amauryvandenberghe/Bras-robos/05_Documentation/images/anciennes analyses/avant 06-11/sw_articulation_lacet.png

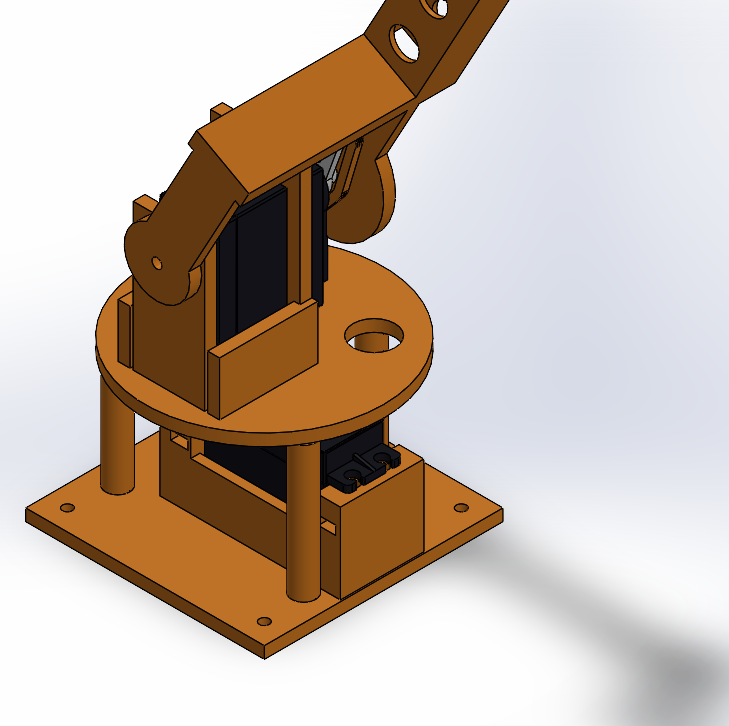
05_Documentation/images/anciennes analyses/avant 06-11/sw_articulation_lacet.png
