amauryvandenberghe/Bras-robos/01_SolidWorks/1_VERSION_FINALE (a ouvrir)/Documents/Bras 50cm (13-11).png

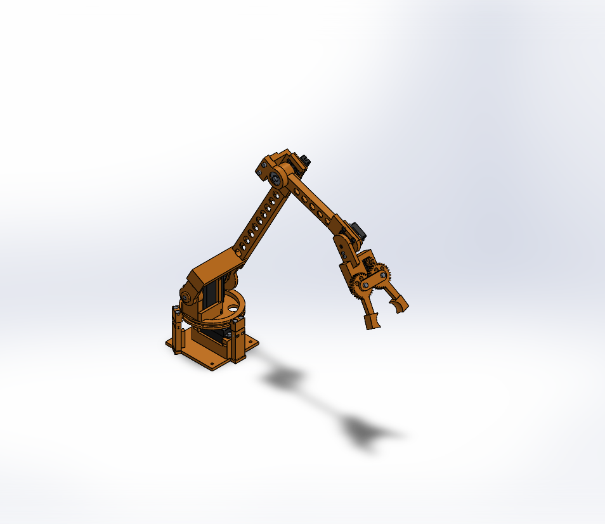
01_SolidWorks/1_VERSION_FINALE (a ouvrir)/Documents/Bras 50cm (13-11).png
