amauryvandenberghe/Bras-robos/01_SolidWorks/3_Anciennes versions/3c_29-10 sans empreintes de palonniers/Bras 50cm.png

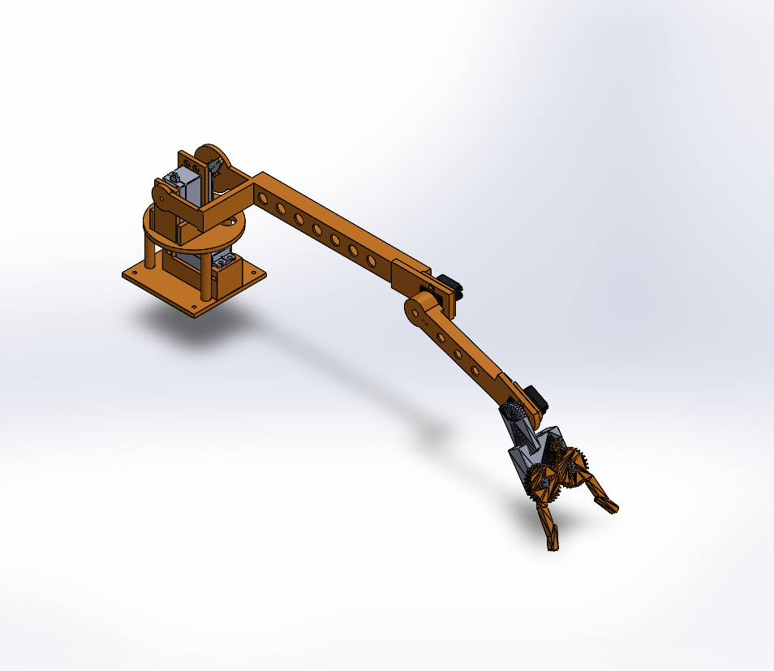
01_SolidWorks/3_Anciennes versions/3c_29-10 sans empreintes de palonniers/Bras 50cm.png
