amauryvandenberghe/Bras-robos/01_SolidWorks/3_Anciennes versions/3g_06-11 avec roulements sans visserie/Bras 50cm.png

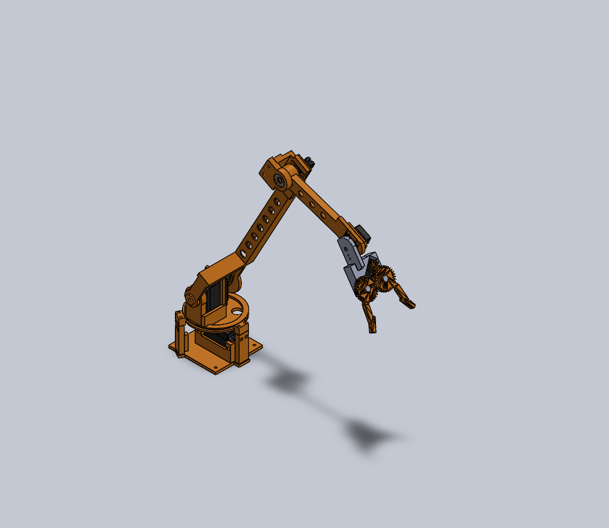
01_SolidWorks/3_Anciennes versions/3g_06-11 avec roulements sans visserie/Bras 50cm.png
