amauryvandenberghe/Bras-robos/01_SolidWorks/3_Anciennes versions/3l_13-11 avant renforts U, patins, pince/Documents/Implantation capteurs 13 mm.png

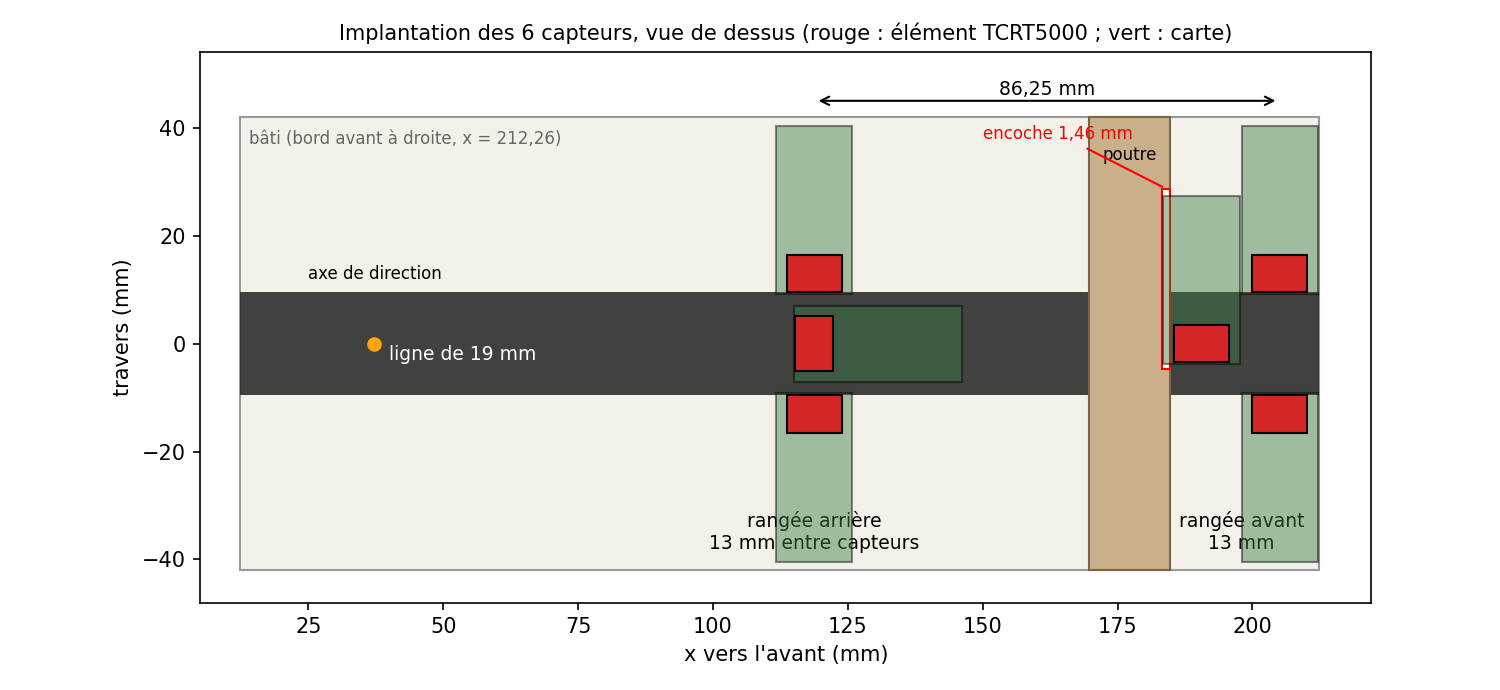
01_SolidWorks/3_Anciennes versions/3l_13-11 avant renforts U, patins, pince/Documents/Implantation capteurs 13 mm.png
