amauryvandenberghe/Bras-robos/01_SolidWorks/3_Anciennes versions/3l_13-11 avant renforts U, patins, pince/Documents/Vues 07-11/capteurs 2 rangees (iso).png

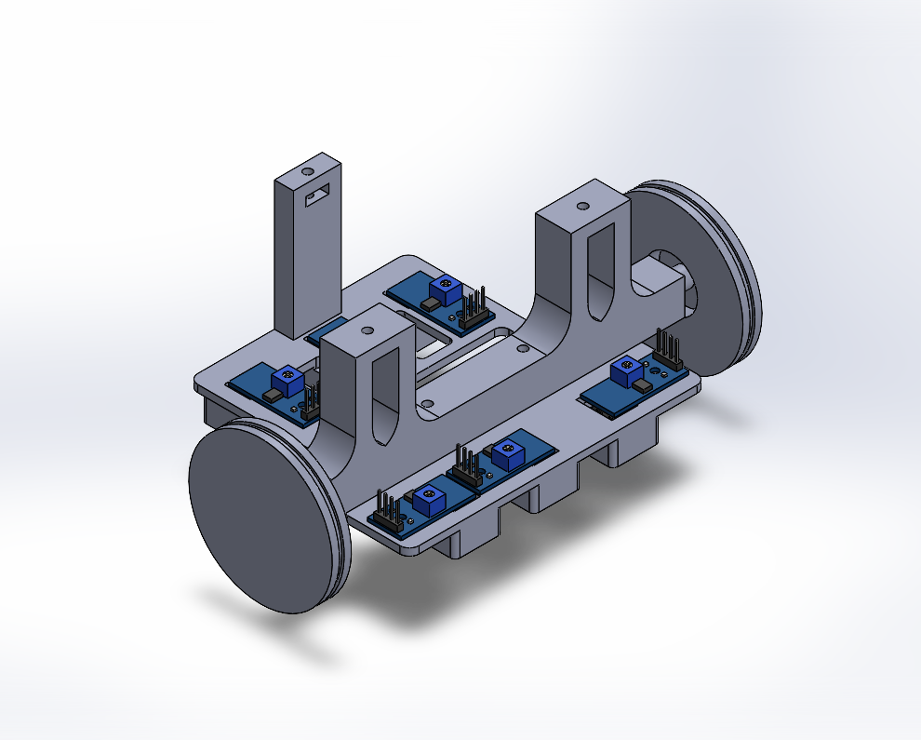
01_SolidWorks/3_Anciennes versions/3l_13-11 avant renforts U, patins, pince/Documents/Vues 07-11/capteurs 2 rangees (iso).png
