amauryvandenberghe/Bras-robos/04_Simulation_Gazebo/parcours/plateau.png

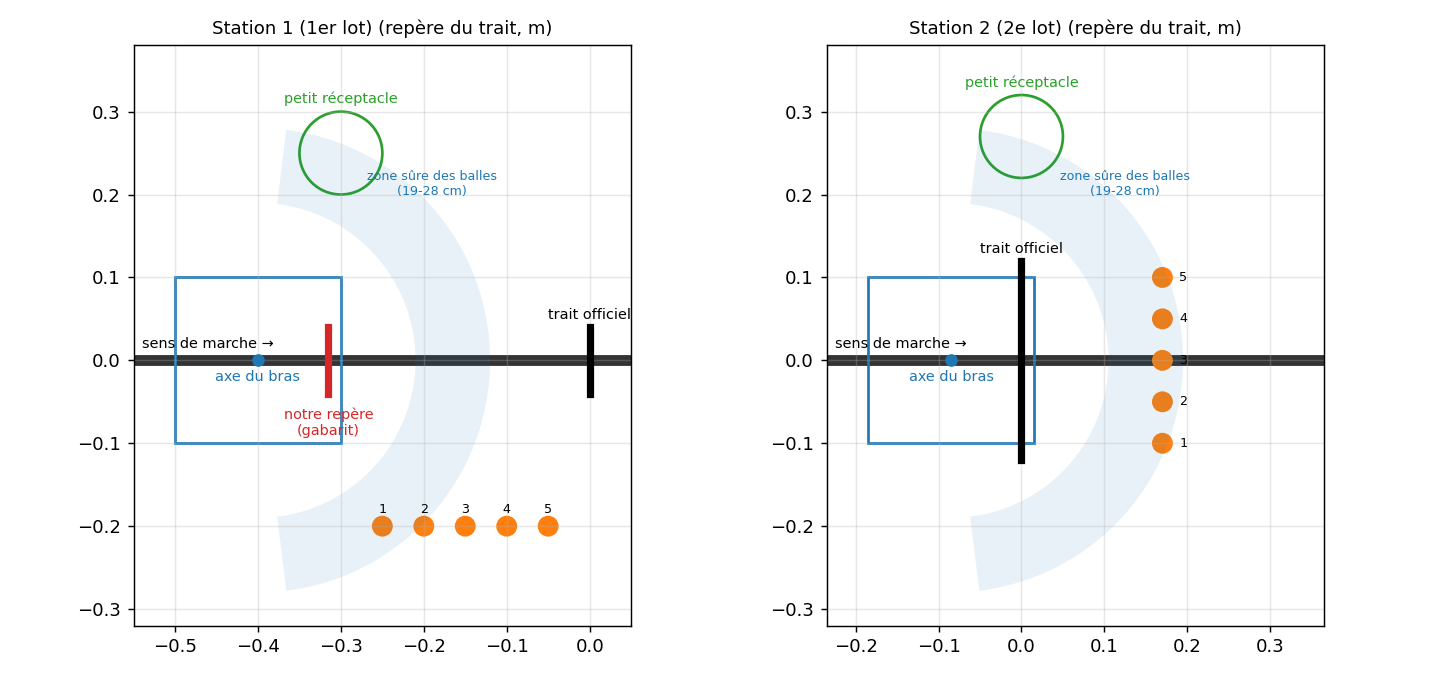
04_Simulation_Gazebo/parcours/plateau.png
