amauryvandenberghe/Bras-robos/05_Documentation/images/anciennes analyses/analyse_avant_bras.png

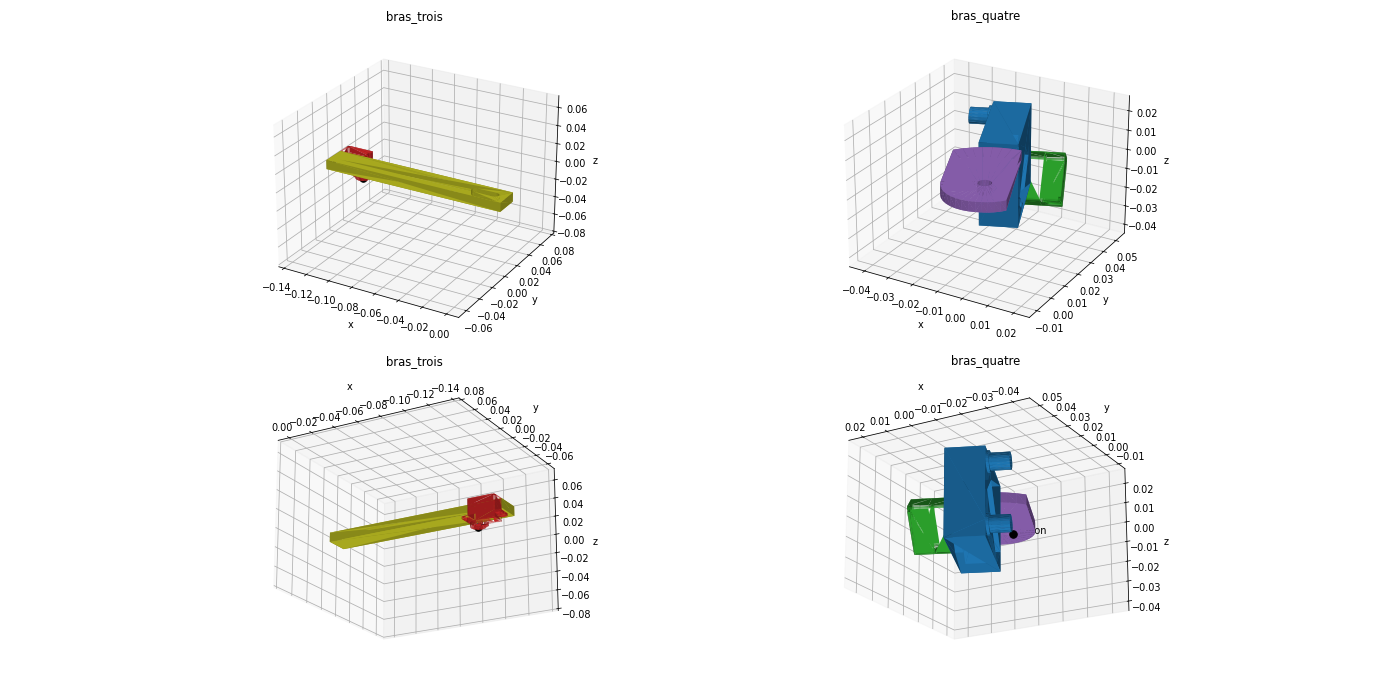
05_Documentation/images/anciennes analyses/analyse_avant_bras.png
