amauryvandenberghe/Bras-robos/05_Documentation/images/anciennes analyses/analyse_pince.png

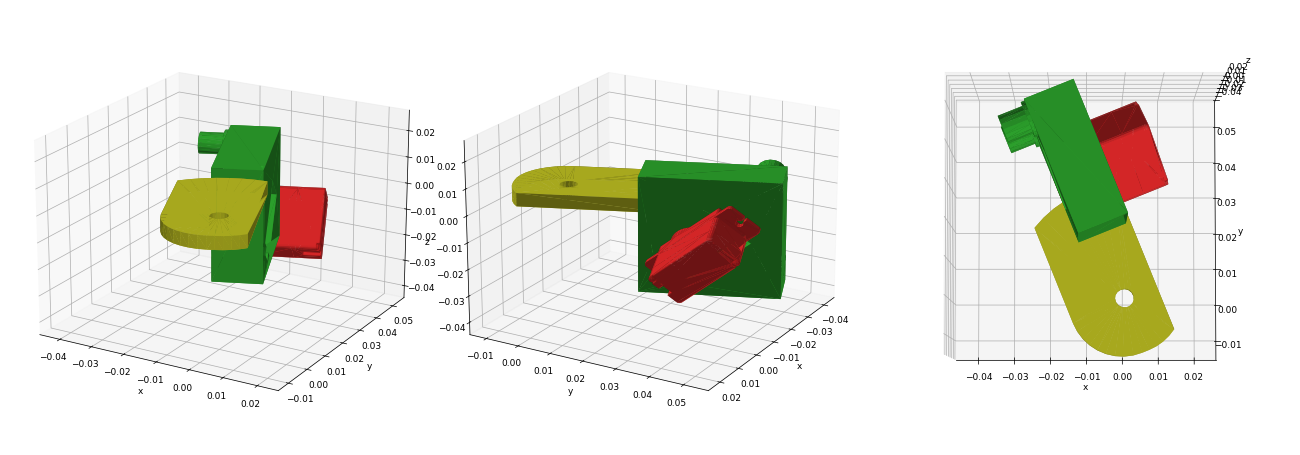
05_Documentation/images/anciennes analyses/analyse_pince.png
