amauryvandenberghe/Bras-robos/05_Documentation/images/anciennes analyses/apercu_pieces.png

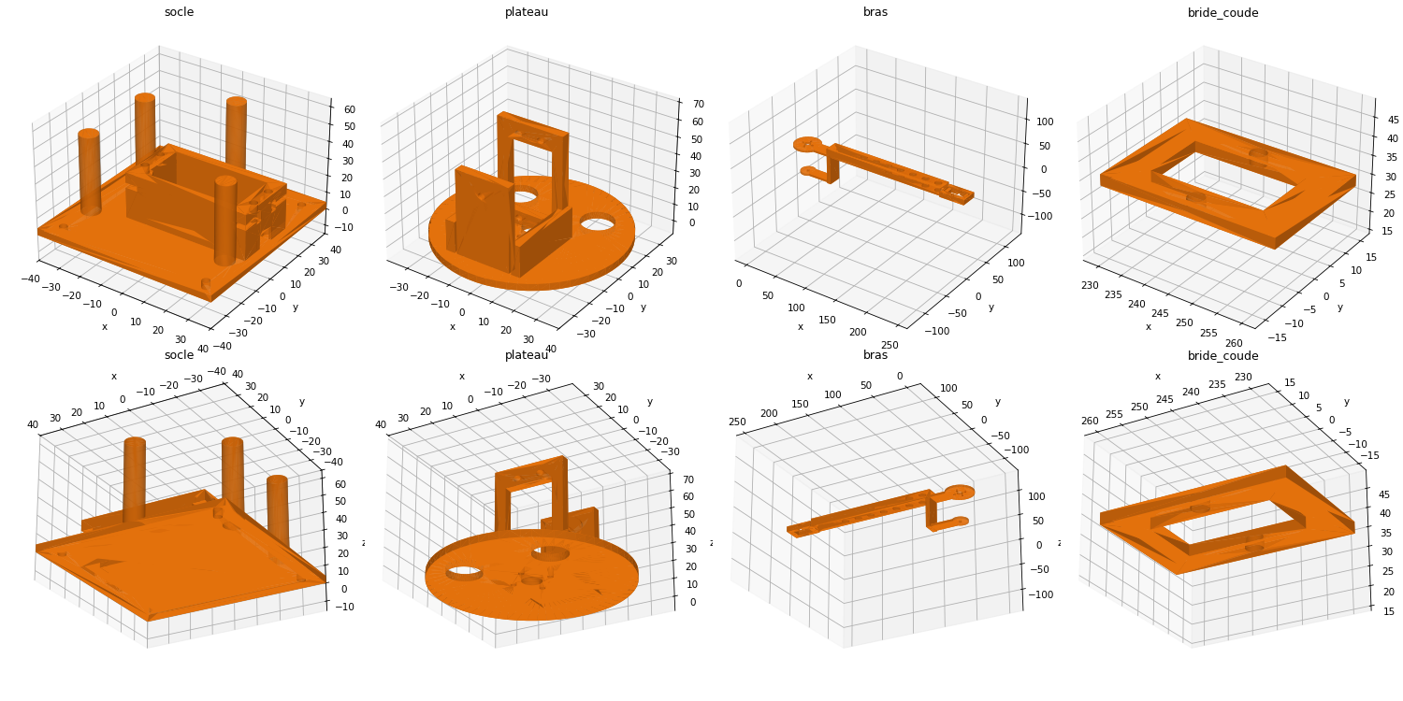
05_Documentation/images/anciennes analyses/apercu_pieces.png
