amauryvandenberghe/Bras-robos/05_Documentation/images/anciennes analyses/avant 06-11/empreinte_avant_bras.png

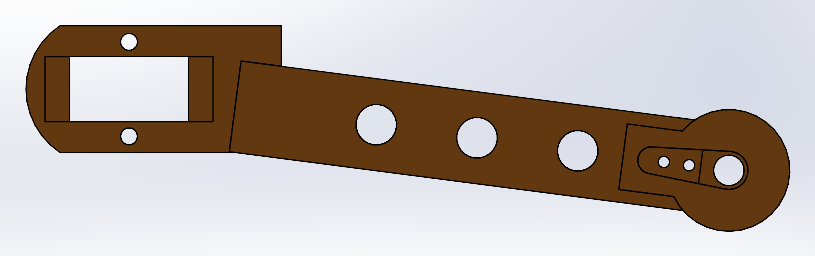
05_Documentation/images/anciennes analyses/avant 06-11/empreinte_avant_bras.png
