amauryvandenberghe/Bras-robos/05_Documentation/images/anciennes analyses/avant 06-11/empreinte_corps_pince.png

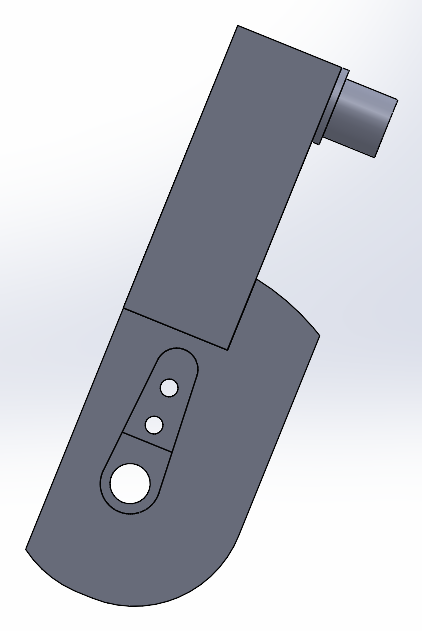
05_Documentation/images/anciennes analyses/avant 06-11/empreinte_corps_pince.png
