amauryvandenberghe/Bras-robos/05_Documentation/images/anciennes analyses/logements_servos.png

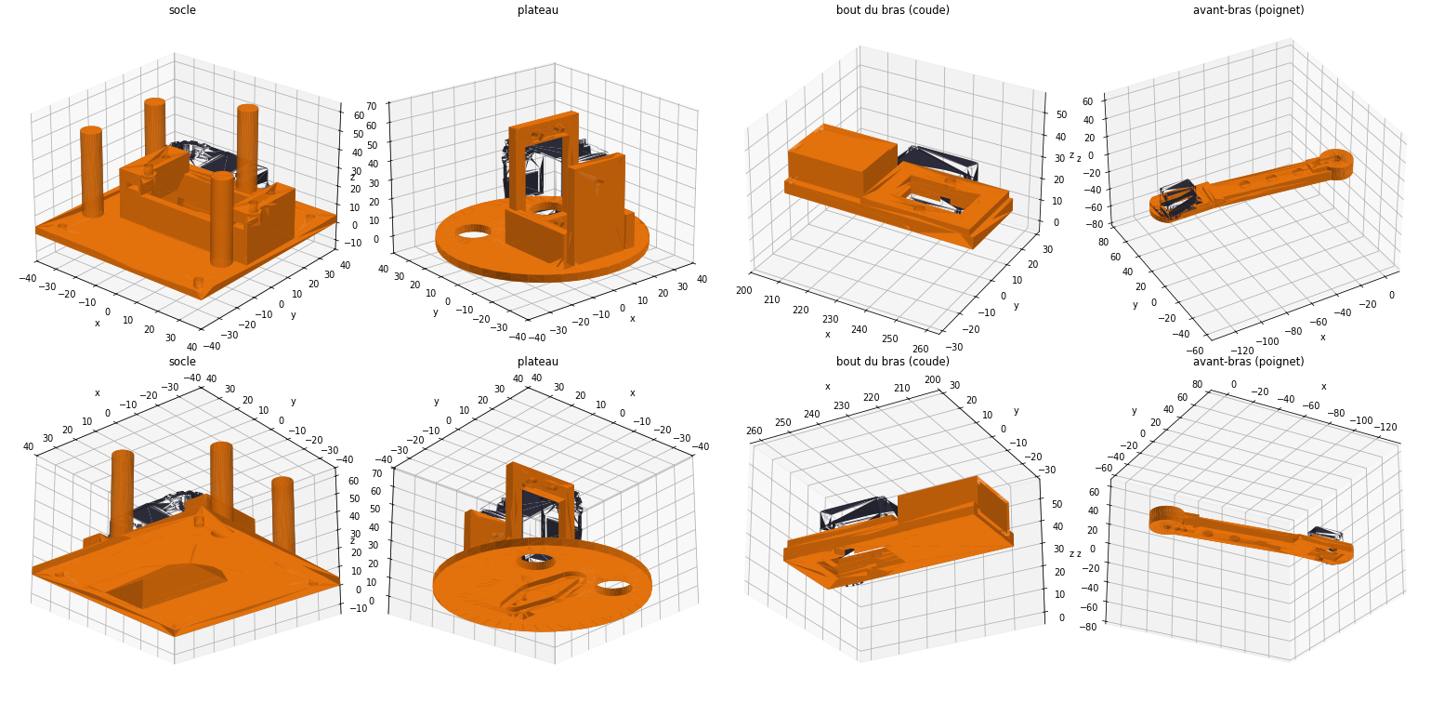
05_Documentation/images/anciennes analyses/logements_servos.png
