amauryvandenberghe/Bras-robos/05_Documentation/images/empreinte_avant_bras.png

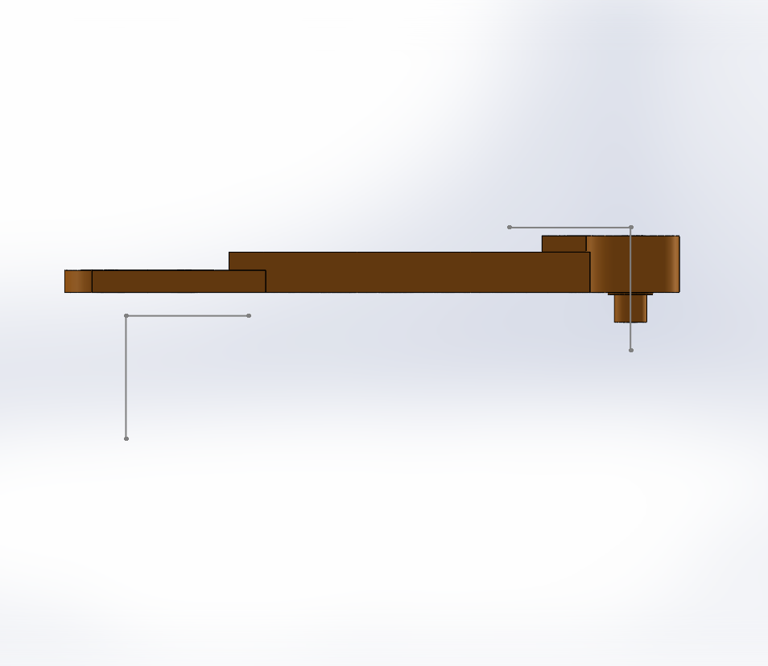
05_Documentation/images/empreinte_avant_bras.png
