amauryvandenberghe/Bras-robos/05_Documentation/images/empreinte_corps_pince.png

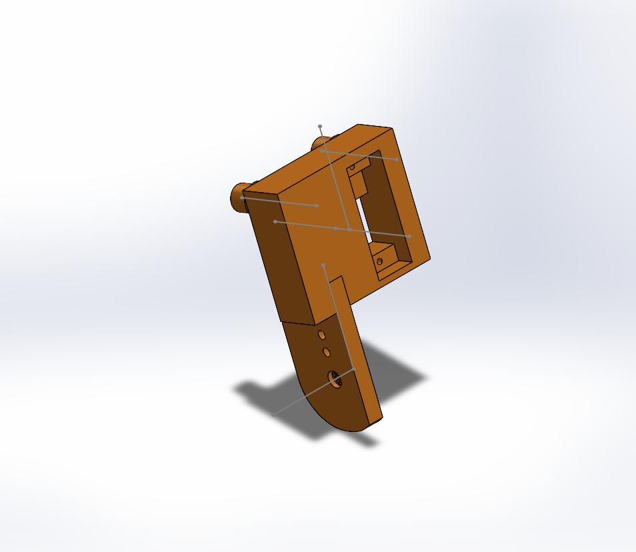
05_Documentation/images/empreinte_corps_pince.png
