amauryvandenberghe/Bras-robos/05_Documentation/images/empreinte_plateau.png

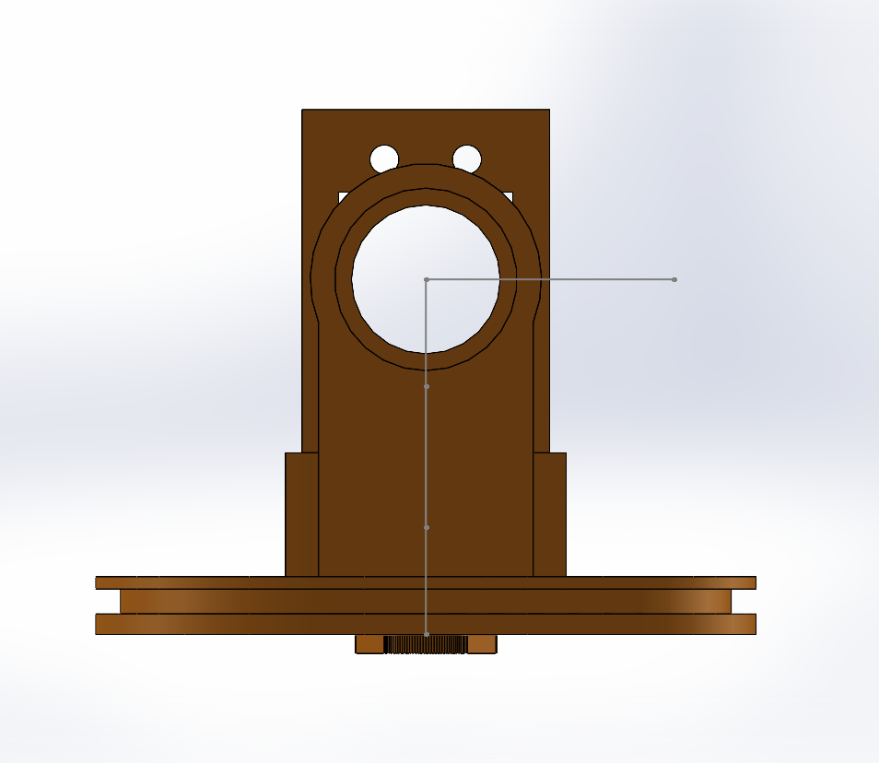
05_Documentation/images/empreinte_plateau.png
