amauryvandenberghe/Bras-robos/05_Documentation/images/sw_articulation_coude.png

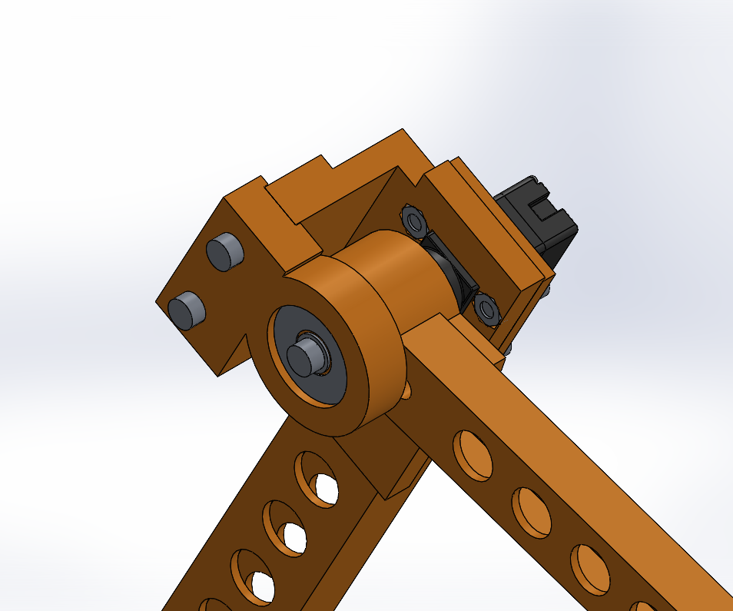
05_Documentation/images/sw_articulation_coude.png
