amauryvandenberghe/Bras-robos/05_Documentation/images/sw_articulation_lacet.png

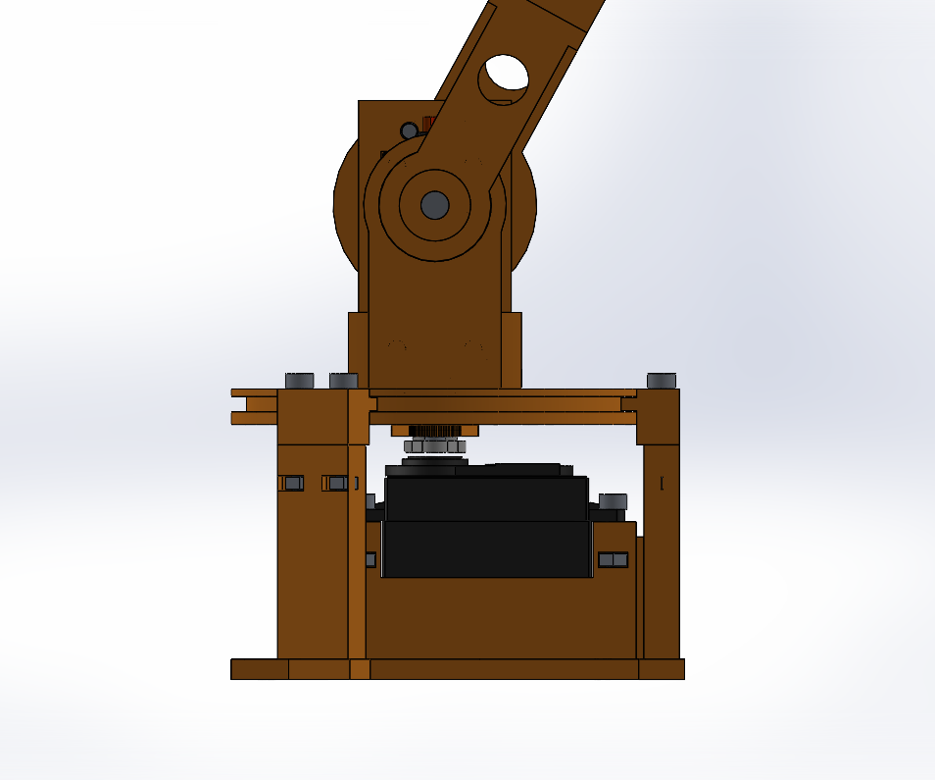
05_Documentation/images/sw_articulation_lacet.png
