amauryvandenberghe/Bras-robos/01_SolidWorks/2_Pieces d'origine (copies de vos fichiers)/MG996R SERVO/MG996R SBORKA.SLDASM

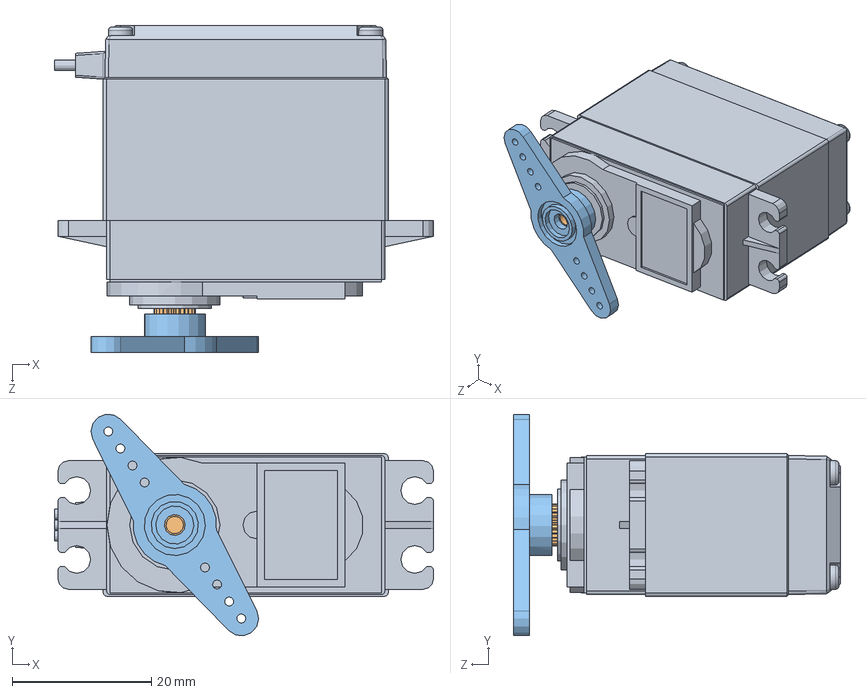
[picture p54: CAD file, 2026-11-08]
01_SolidWorks/2_Pieces d'origine (copies de vos fichiers)/MG996R SERVO/MG996R SBORKA.SLDASM
54.5 x 31.8 x 47.0 mm
Servo MG996R
Servo MG996R Shaft
Servo MG996R arm01
