amauryvandenberghe/Bras-robos/01_SolidWorks/2_Pieces d'origine (copies de vos fichiers)/MG996R SBORKA.SLDASM

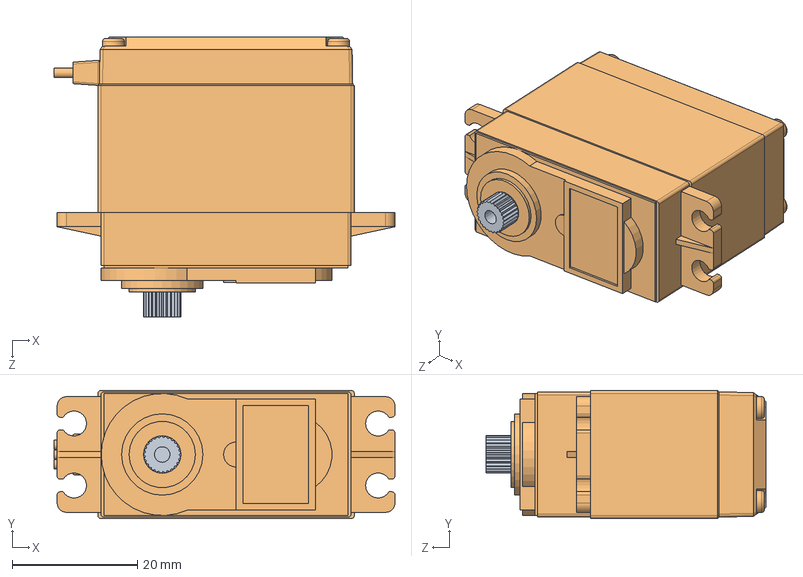
[picture p55: CAD file, 2026-11-08]
01_SolidWorks/2_Pieces d'origine (copies de vos fichiers)/MG996R SBORKA.SLDASM
54.5 x 20.5 x 44.7 mm
Servo MG996R
Servo MG996R Shaft
