amauryvandenberghe/Bras-robos/01_SolidWorks/3_Anciennes versions/3g_06-11 avec roulements sans visserie/Bras 50cm.SLDASM

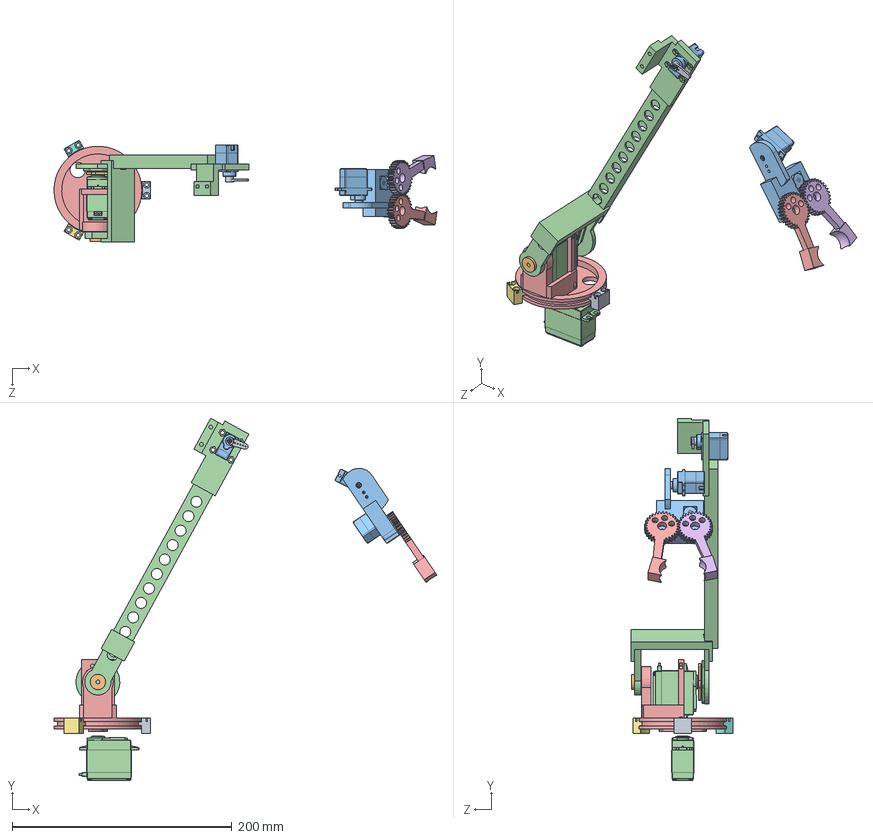
[picture p56: CAD file, 2026-11-08]
01_SolidWorks/3_Anciennes versions/3g_06-11 avec roulements sans visserie/Bras 50cm.SLDASM
348.8 x 330.2 x 92.6 mm
plateau
bras
corps_pince
axe_epaule
patin_a
patin_b
patin_c
machoire_a
machoire_b
Servo MG996R x 2
Servo MG90S x 3
Servo MG996R arm01
broche x 2
