amauryvandenberghe/Bras-robos/01_SolidWorks/2_Pieces d'origine (copies de vos fichiers)/Assemblage1.SLDASM

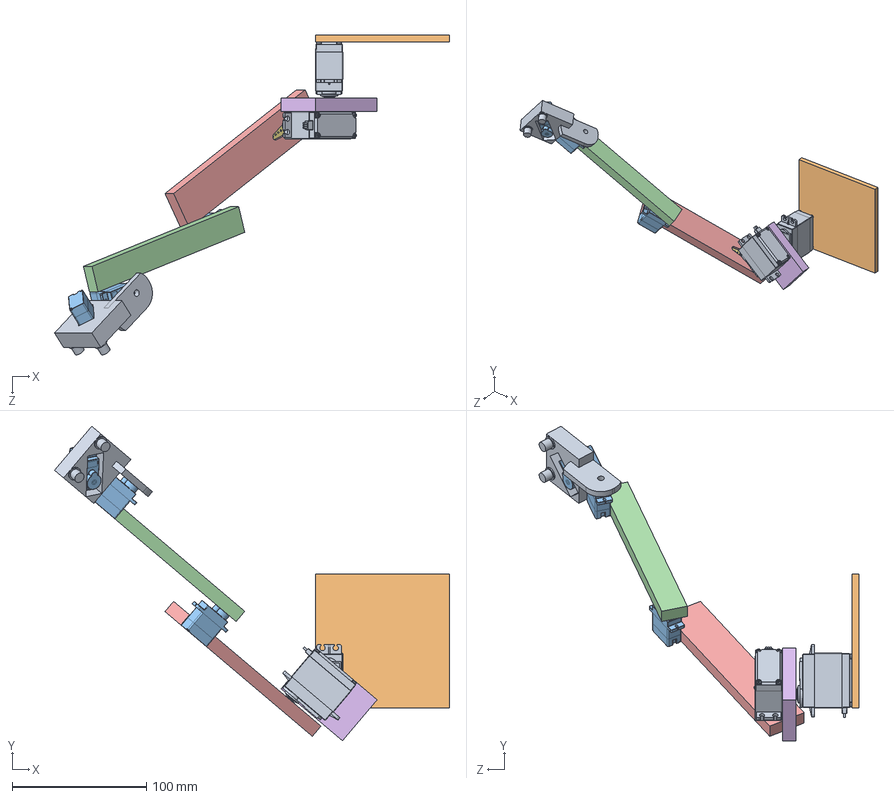
[picture p57: CAD file, 2026-11-08]
01_SolidWorks/2_Pieces d'origine (copies de vos fichiers)/Assemblage1.SLDASM
294.5 x 234.5 x 238.4 mm
bati
Servo MG996R x 2
Servo MG996R Shaft x 2
Servo MG996R arm01 x 2
support1
support 2
support 3
Servo Motor Micro MG90S x 3
broche
pince
