amauryvandenberghe/Bras-robos/01_SolidWorks/3_Anciennes versions/3d_30-10 contraintes en conflit/Bras 50cm.SLDASM

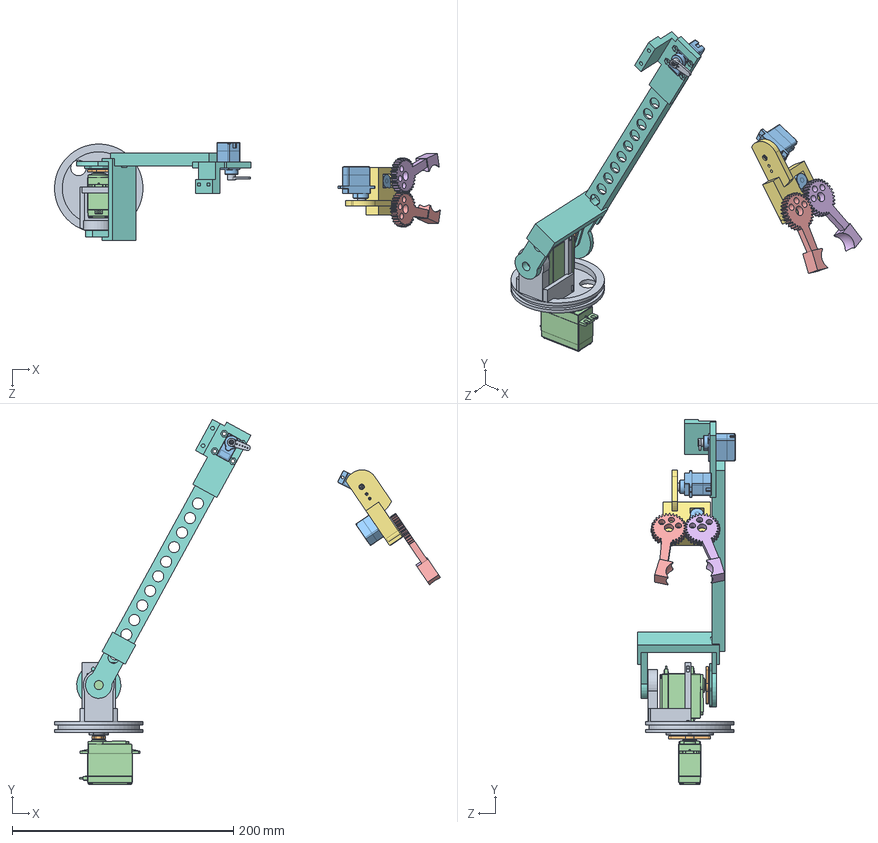
[picture p58: CAD file, 2026-11-08]
01_SolidWorks/3_Anciennes versions/3d_30-10 contraintes en conflit/Bras 50cm.SLDASM
348.8 x 330.2 x 88.2 mm
plateau
bras
corps_pince
machoire_a
machoire_b
Servo MG996R x 2
Servo MG90S x 3
Servo MG996R arm01 x 2
broche x 2
