amauryvandenberghe/Bras-robos/01_SolidWorks/1_VERSION_FINALE (a ouvrir)/Pieces bras/machoire_a.SLDPRT

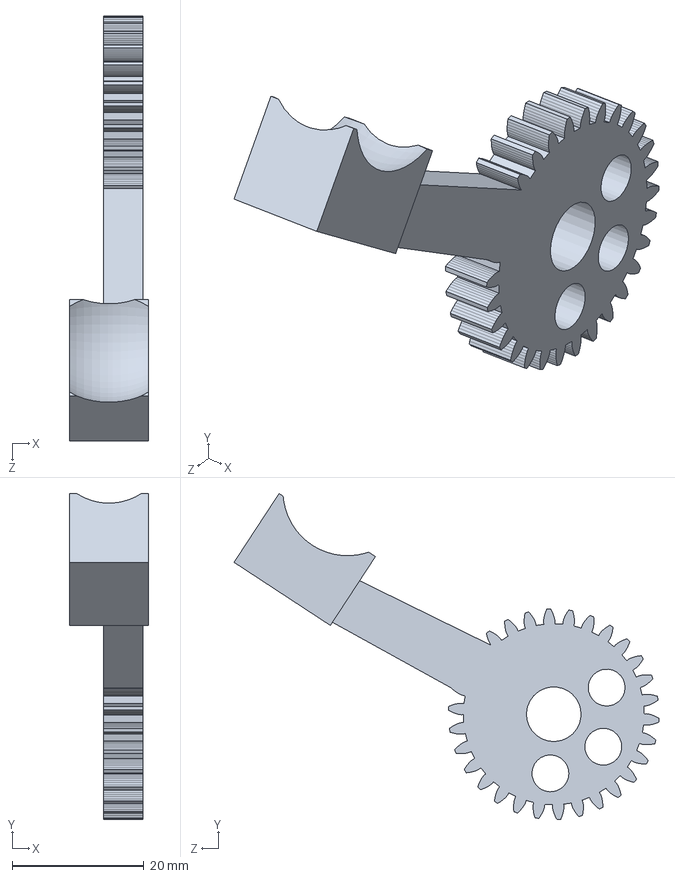
[picture p59: CAD file, 2026-11-13]
01_SolidWorks/1_VERSION_FINALE (a ouvrir)/Pieces bras/machoire_a.SLDPRT
12.0 x 49.5 x 64.6 mm
