amauryvandenberghe/Bras-robos/01_SolidWorks/2_Pieces d'origine (copies de vos fichiers)/bati.SLDPRT

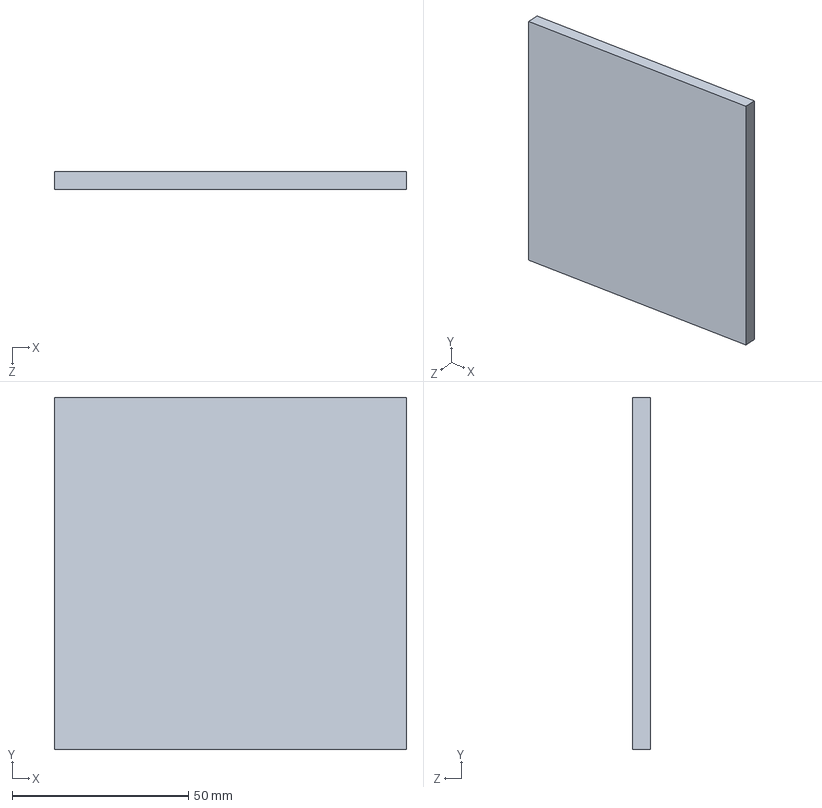
[picture p60: CAD file, 2026-11-08]
01_SolidWorks/2_Pieces d'origine (copies de vos fichiers)/bati.SLDPRT
100.0 x 100.0 x 5.00 mm
