amauryvandenberghe/Bras-robos/01_SolidWorks/3_Anciennes versions/3e_06-11 avant roulements/02_Impression_3D/pignon_pince.STL

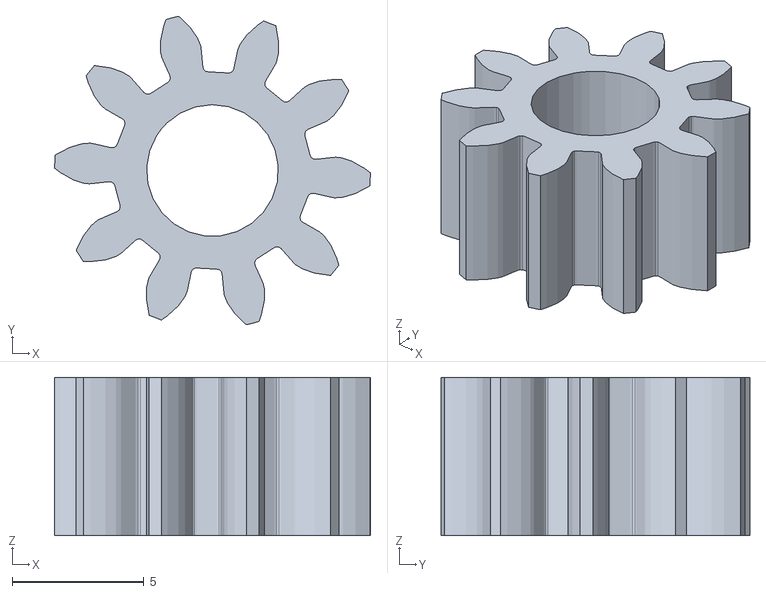
[picture p61: CAD file, 2026-11-08]
01_SolidWorks/3_Anciennes versions/3e_06-11 avant roulements/02_Impression_3D/pignon_pince.STL
12.0 x 11.7 x 6.00
