amauryvandenberghe/Bras-robos/01_SolidWorks/3_Anciennes versions/3g_06-11 avec roulements sans visserie/02_Impression_3D/plateau.stl

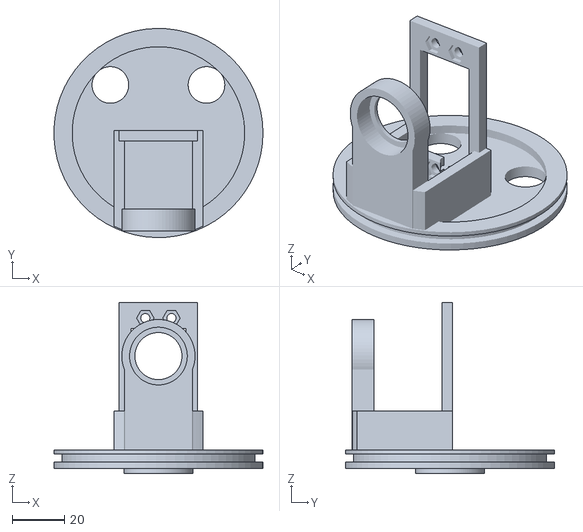
[picture p62: CAD file, 2026-11-08]
01_SolidWorks/3_Anciennes versions/3g_06-11 avec roulements sans visserie/02_Impression_3D/plateau.stl
80.0 x 80.0 x 65.6
