amauryvandenberghe/Bras-robos/01_SolidWorks/3_Anciennes versions/3h_07-11 avant servo de pince droit et support capteurs/socle.step

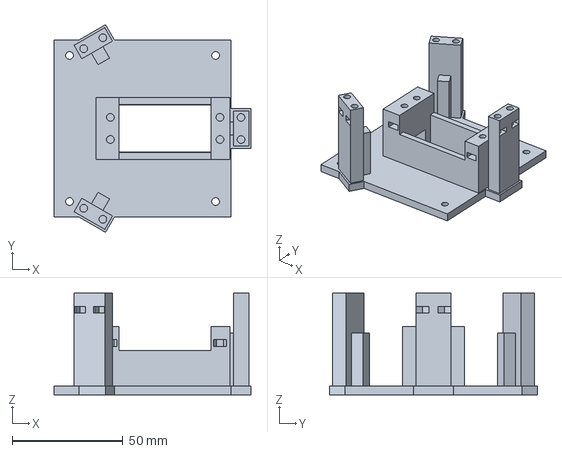
[picture p63: CAD file, 2026-11-08]
01_SolidWorks/3_Anciennes versions/3h_07-11 avant servo de pince droit et support capteurs/socle.step
89.0 x 93.9 x 46.0 mm
