amauryvandenberghe/Bras-robos/01_SolidWorks/3_Anciennes versions/3j_08-11 capteurs a 33 mm/piece avec les bites.SLDPRT

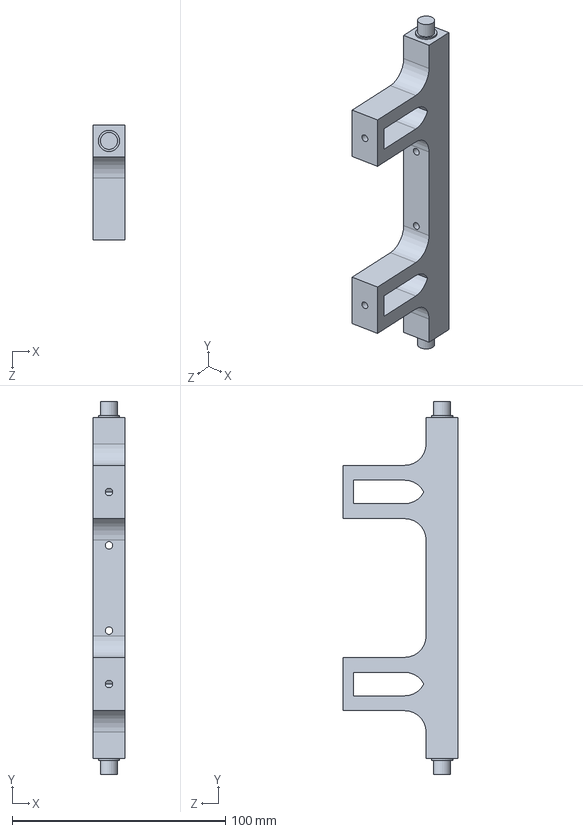
[picture p64: CAD file, 2026-11-08]
01_SolidWorks/3_Anciennes versions/3j_08-11 capteurs a 33 mm/piece avec les bites.SLDPRT
15.0 x 174.8 x 54.0 mm
