amauryvandenberghe/Bras-robos/01_SolidWorks/3_Anciennes versions/3l_13-11 avant renforts U, patins, pince/Impression/patin_b.stl

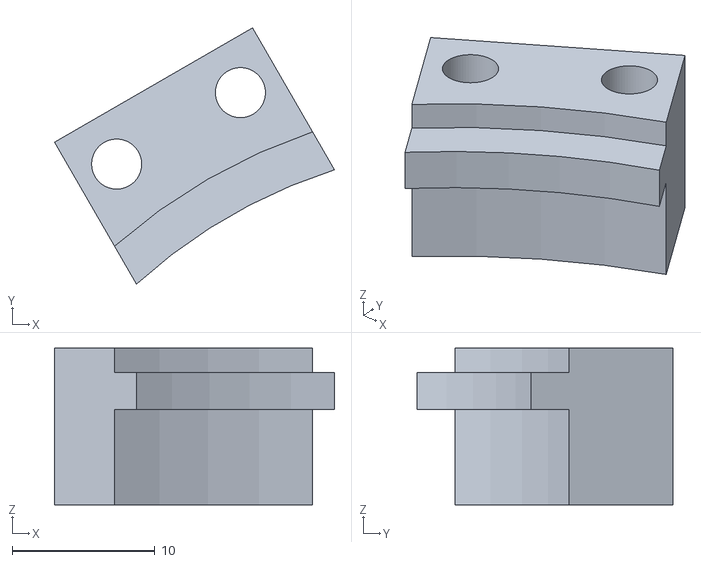
[picture p65: CAD file, 2026-11-08]
01_SolidWorks/3_Anciennes versions/3l_13-11 avant renforts U, patins, pince/Impression/patin_b.stl
19.6 x 17.9 x 11.0
