amauryvandenberghe/Bras-robos/01_SolidWorks/3_Anciennes versions/3l_13-11 avant renforts U, patins, pince/Pieces bras/Roulement 608.step

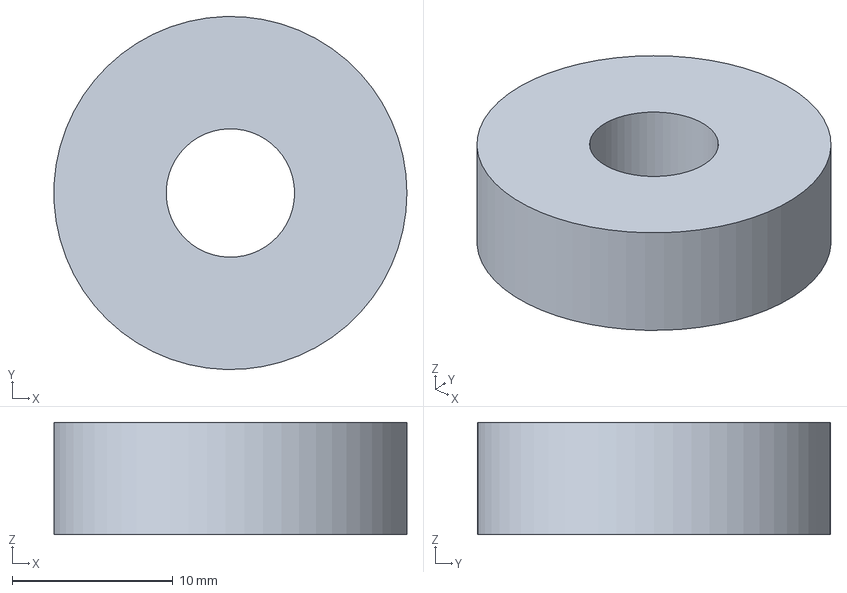
[picture p66: CAD file, 2026-11-08]
01_SolidWorks/3_Anciennes versions/3l_13-11 avant renforts U, patins, pince/Pieces bras/Roulement 608.step
22.0 x 22.0 x 7.00 mm
