amauryvandenberghe/Bras-robos/01_SolidWorks/3_Anciennes versions/3l_13-11 avant renforts U, patins, pince/Pieces robot/bati(en cours).SLDPRT

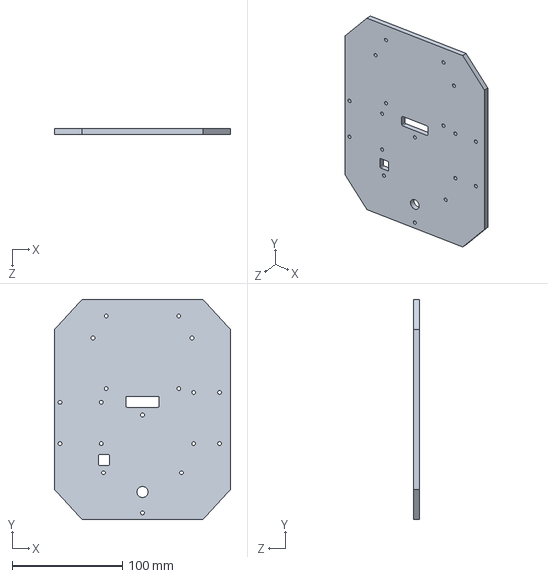
[picture p67: CAD file, 2026-11-08]
01_SolidWorks/3_Anciennes versions/3l_13-11 avant renforts U, patins, pince/Pieces robot/bati(en cours).SLDPRT
160.0 x 200.0 x 5.00 mm
