amauryvandenberghe/Bras-robos/02_Impression_3D/bras.stl

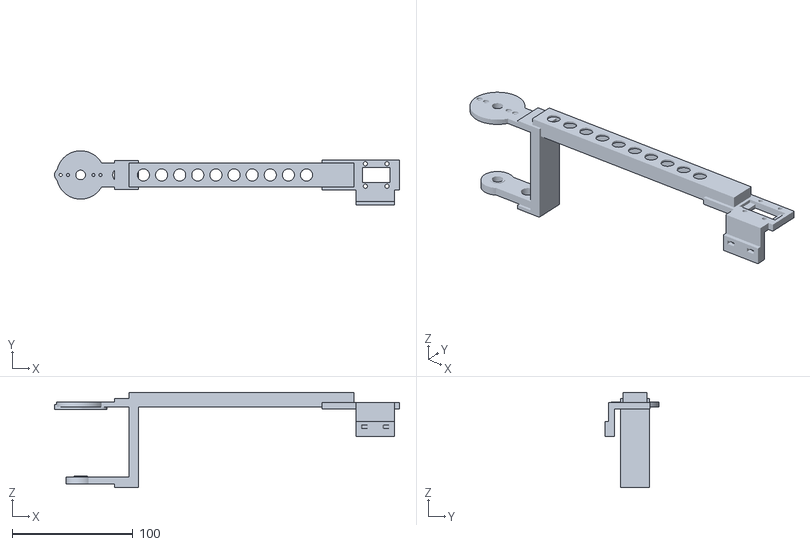
[picture p69: CAD file, 2026-11-13]
02_Impression_3D/bras.stl
285.6 x 45.0 x 79.0
