amauryvandenberghe/Bras-robos/04_Simulation_Gazebo/bras_50cm/servos/mg996r.step

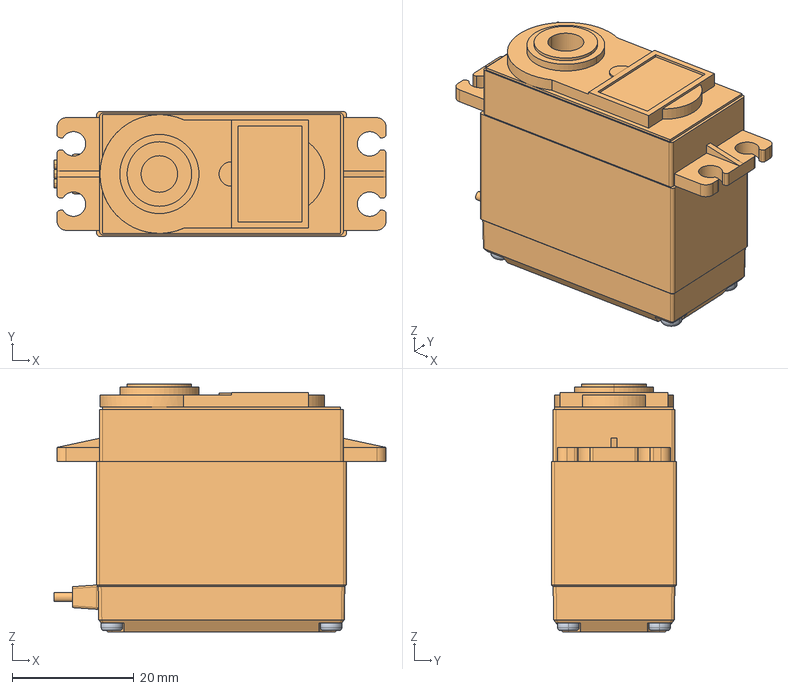
[picture p70: CAD file, 2026-11-08]
04_Simulation_Gazebo/bras_50cm/servos/mg996r.step
54.5 x 20.5 x 40.7 mm
