amauryvandenberghe/Bras-robos/04_Simulation_Gazebo/meshes/bras_50cm/bride_coude.stl

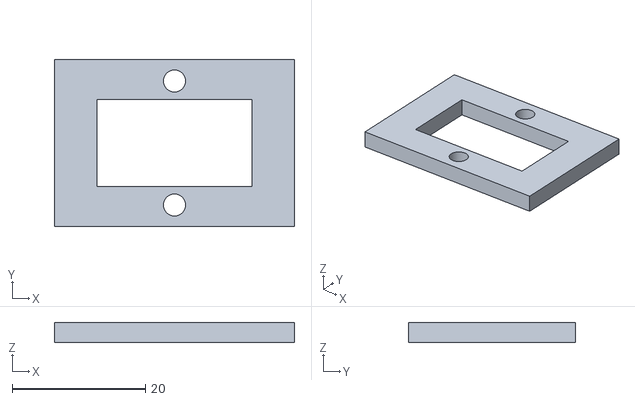
[picture p71: CAD file, 2026-11-08]
04_Simulation_Gazebo/meshes/bras_50cm/bride_coude.stl
36.0 x 25.0 x 3.00
