amauryvandenberghe/Bras-robos/04_Simulation_Gazebo/meshes/vis_un_4.stl

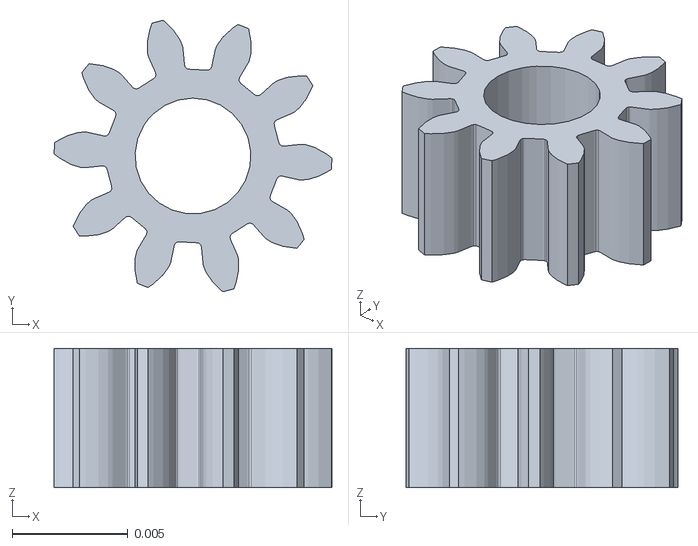
[picture p72: CAD file, 2026-11-08]
04_Simulation_Gazebo/meshes/vis_un_4.stl
0.012 x 0.0117 x 0.006
