amauryvandenberghe/Bras-robos/01_SolidWorks/1_VERSION_FINALE (a ouvrir)/Pieces bras/patin_b.SLDPRT

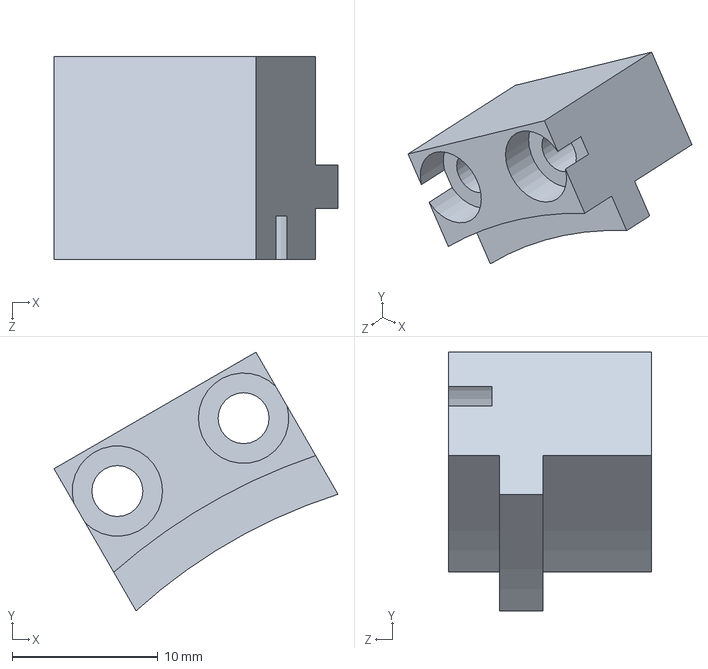
[picture p73: CAD file, 2026-11-13]
01_SolidWorks/1_VERSION_FINALE (a ouvrir)/Pieces bras/patin_b.SLDPRT
19.5 x 17.8 x 13.9 mm
