amauryvandenberghe/Bras-robos/01_SolidWorks/2_Pieces d'origine (copies de vos fichiers)/MG996R SERVO/Servo MG996R arm01.SLDPRT

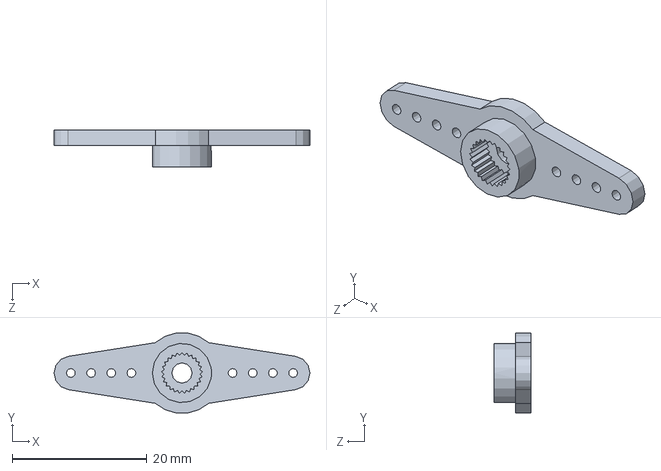
[picture p74: CAD file, 2026-11-08]
01_SolidWorks/2_Pieces d'origine (copies de vos fichiers)/MG996R SERVO/Servo MG996R arm01.SLDPRT
38.0 x 11.9 x 5.50 mm
