amauryvandenberghe/Bras-robos/01_SolidWorks/3_Anciennes versions/3a_premiere version sans contraintes/socle.step

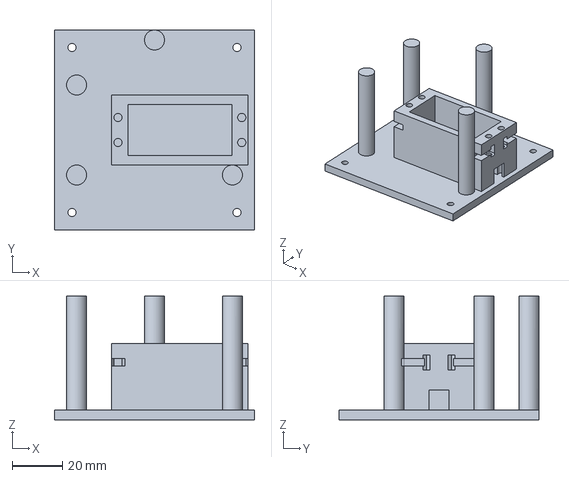
[picture p75: CAD file, 2026-11-08]
01_SolidWorks/3_Anciennes versions/3a_premiere version sans contraintes/socle.step
80.0 x 80.0 x 49.5 mm
