amauryvandenberghe/Bras-robos/01_SolidWorks/3_Anciennes versions/3e_06-11 avant roulements/02_Impression_3D/bras.stl

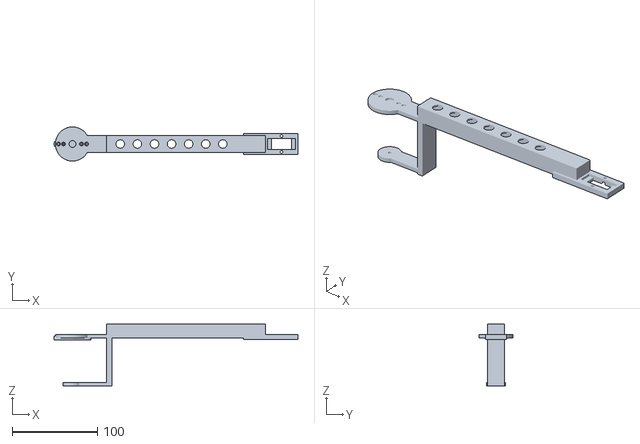
[picture p76: CAD file, 2026-11-08]
01_SolidWorks/3_Anciennes versions/3e_06-11 avant roulements/02_Impression_3D/bras.stl
285.6 x 40.0 x 72.0
