amauryvandenberghe/Bras-robos/01_SolidWorks/3_Anciennes versions/3h_07-11 avant servo de pince droit et support capteurs/broche.SLDPRT

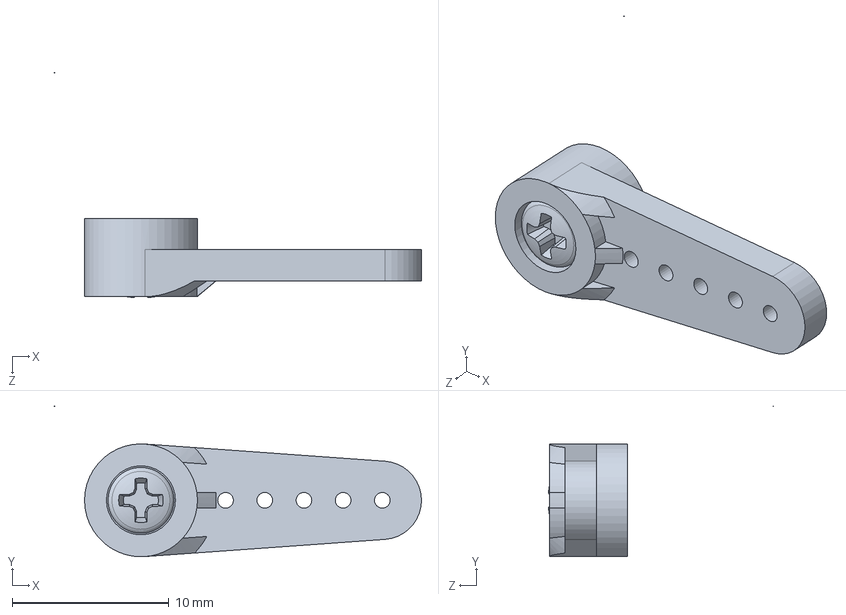
[picture p77: CAD file, 2026-11-08]
01_SolidWorks/3_Anciennes versions/3h_07-11 avant servo de pince droit et support capteurs/broche.SLDPRT
23.4 x 9.60 x 14.4 mm
