amauryvandenberghe/Bras-robos/01_SolidWorks/3_Anciennes versions/3l_13-11 avant renforts U, patins, pince/Impression/patin_a.stl

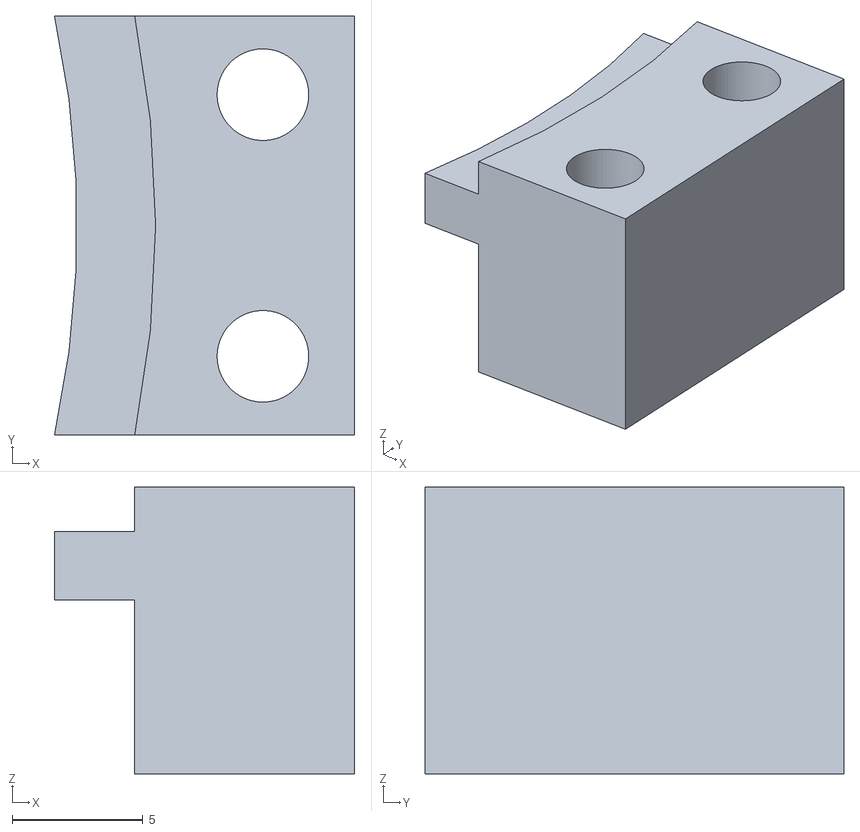
[picture p78: CAD file, 2026-11-08]
01_SolidWorks/3_Anciennes versions/3l_13-11 avant renforts U, patins, pince/Impression/patin_a.stl
11.5 x 16.0 x 11.0
