amauryvandenberghe/Bras-robos/01_SolidWorks/3_Anciennes versions/3l_13-11 avant renforts U, patins, pince/Pieces robot/cuve direction.step

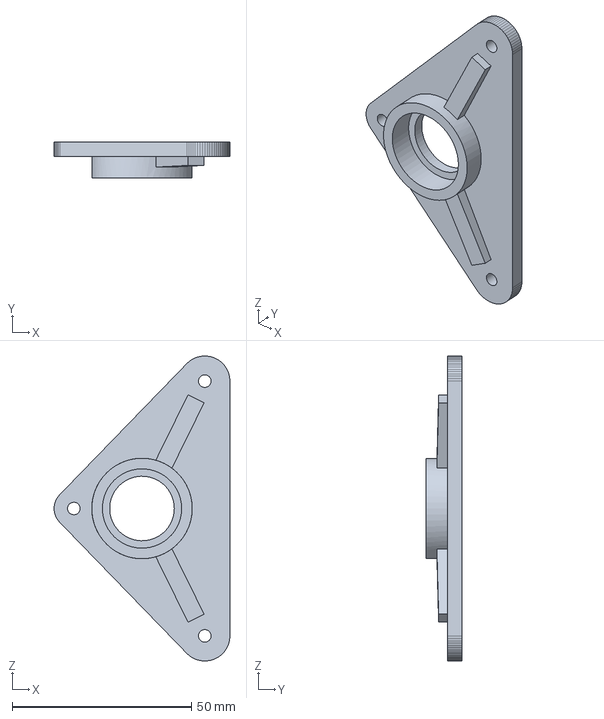
[picture p79: CAD file, 2026-11-08]
01_SolidWorks/3_Anciennes versions/3l_13-11 avant renforts U, patins, pince/Pieces robot/cuve direction.step
49.0 x 9.99 x 85.0 mm
