amauryvandenberghe/Bras-robos/02_Impression_3D/patin_a.stl

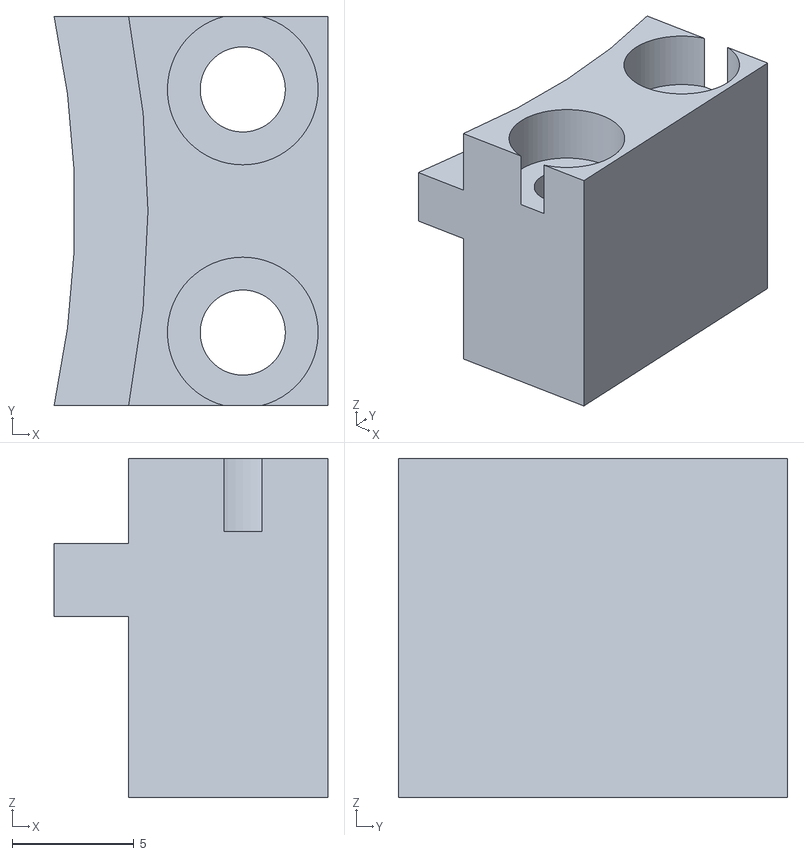
[picture p80: CAD file, 2026-11-13]
02_Impression_3D/patin_a.stl
11.3 x 16.0 x 14.0
