amauryvandenberghe/Bras-robos/04_Simulation_Gazebo/meshes/bras_50cm/plateau.stl

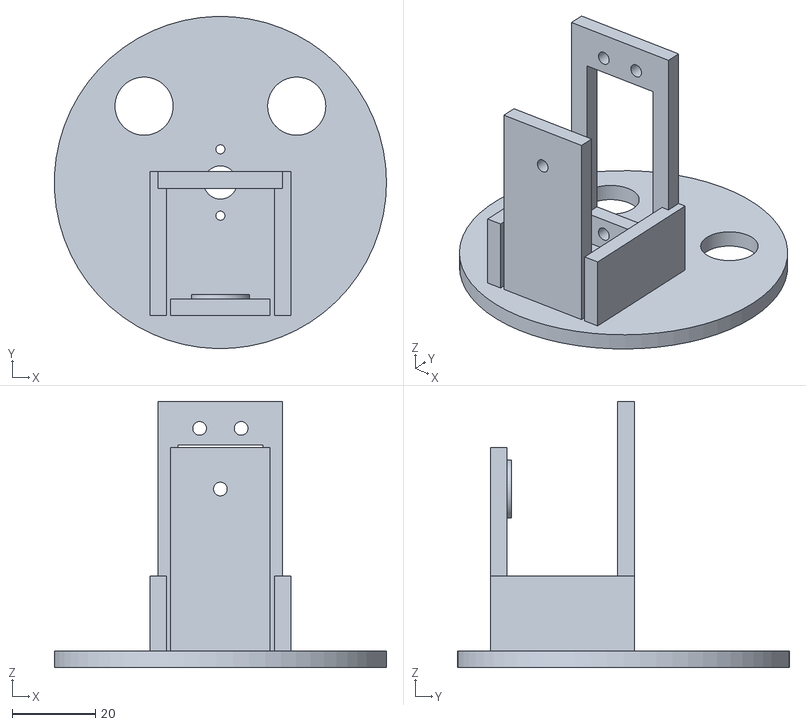
[picture p81: CAD file, 2026-11-08]
04_Simulation_Gazebo/meshes/bras_50cm/plateau.stl
80.0 x 80.0 x 64.1
