amauryvandenberghe/Bras-robos/04_Simulation_Gazebo/meshes/vis_trois_4.stl

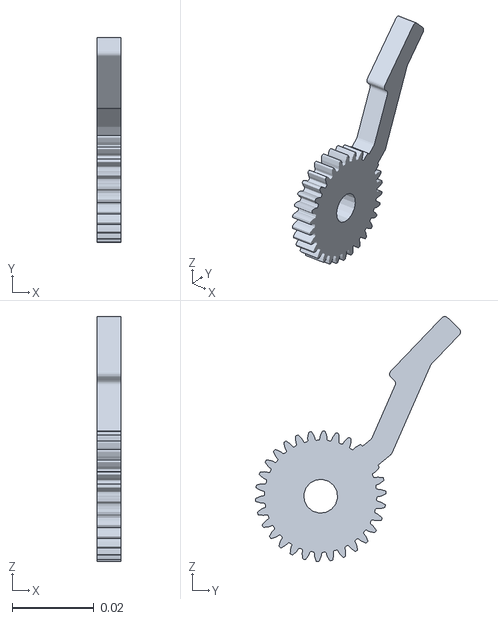
[picture p82: CAD file, 2026-11-08]
04_Simulation_Gazebo/meshes/vis_trois_4.stl
0.006 x 0.0503 x 0.06
