amauryvandenberghe/Bras-robos/01_SolidWorks/1_VERSION_FINALE (a ouvrir)/Pieces bras/axe_epaule.SLDPRT

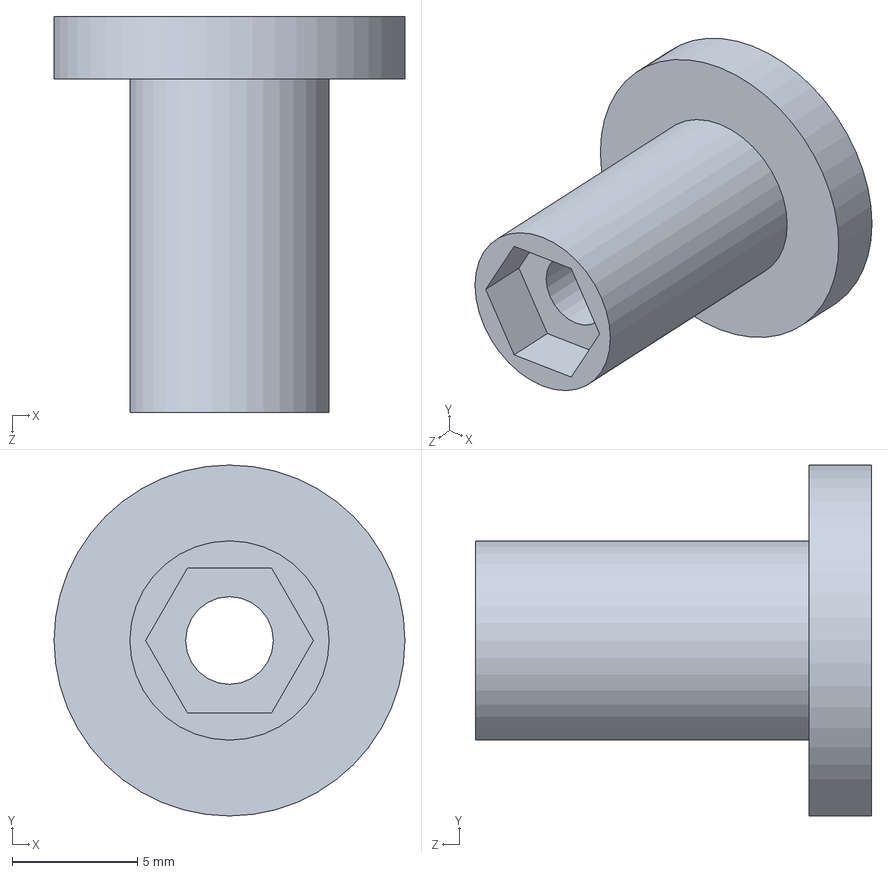
[picture p83: CAD file, 2026-11-13]
01_SolidWorks/1_VERSION_FINALE (a ouvrir)/Pieces bras/axe_epaule.SLDPRT
14.0 x 14.0 x 15.8 mm
