amauryvandenberghe/Bras-robos/01_SolidWorks/2_Pieces d'origine (copies de vos fichiers)/Servo Motor Micro MG90S.SLDPRT

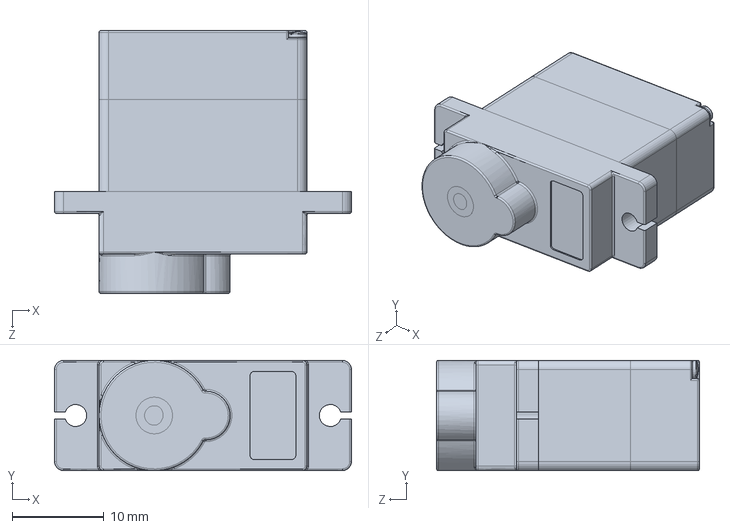
[picture p84: CAD file, 2026-11-08]
01_SolidWorks/2_Pieces d'origine (copies de vos fichiers)/Servo Motor Micro MG90S.SLDPRT
32.3 x 12.0 x 28.6 mm
