amauryvandenberghe/Bras-robos/01_SolidWorks/3_Anciennes versions/3a_premiere version sans contraintes/bras.step

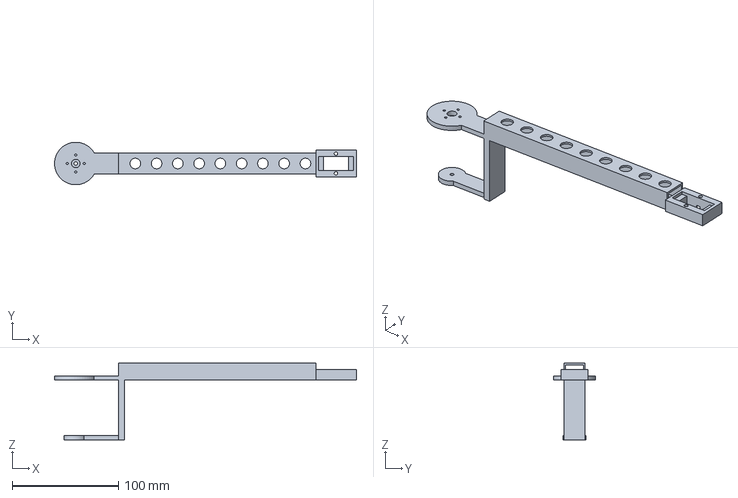
[picture p85: CAD file, 2026-11-08]
01_SolidWorks/3_Anciennes versions/3a_premiere version sans contraintes/bras.step
284.0 x 40.0 x 72.0 mm
