amauryvandenberghe/Bras-robos/01_SolidWorks/3_Anciennes versions/3g_06-11 avec roulements sans visserie/02_Impression_3D/palier_coude.stl

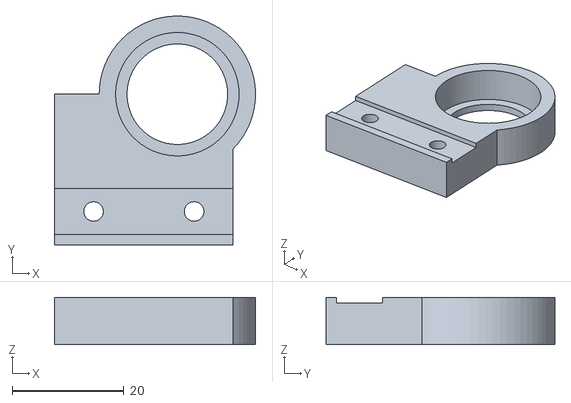
[picture p86: CAD file, 2026-11-08]
01_SolidWorks/3_Anciennes versions/3g_06-11 avec roulements sans visserie/02_Impression_3D/palier_coude.stl
36.0 x 41.0 x 8.50
