amauryvandenberghe/Bras-robos/01_SolidWorks/3_Anciennes versions/3j_08-11 capteurs a 33 mm/support capteurs 2 rangees.step

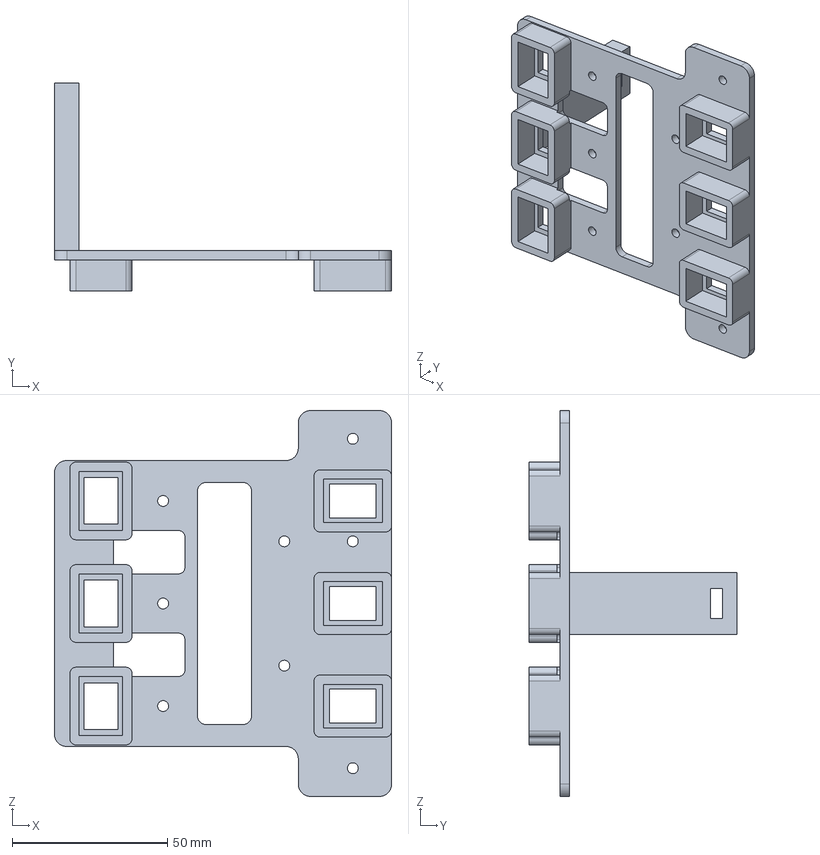
[picture p87: CAD file, 2026-11-08]
01_SolidWorks/3_Anciennes versions/3j_08-11 capteurs a 33 mm/support capteurs 2 rangees.step
108.5 x 67.0 x 124.2 mm
