amauryvandenberghe/Bras-robos/01_SolidWorks/3_Anciennes versions/3l_13-11 avant renforts U, patins, pince/Pieces robot/tige pour direction.SLDPRT

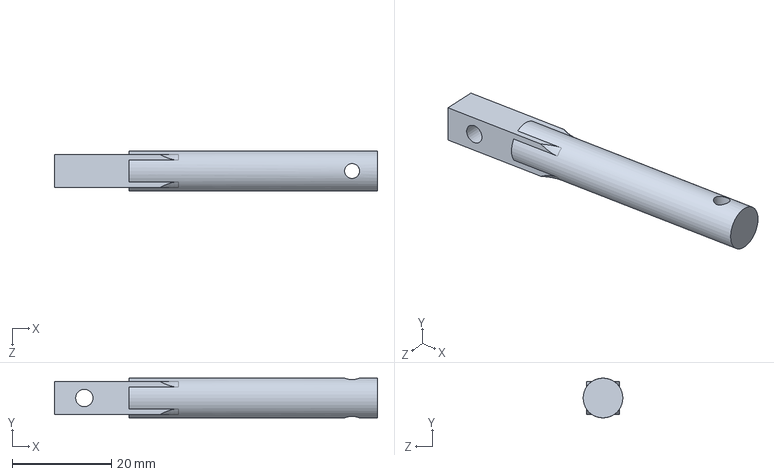
[picture p88: CAD file, 2026-11-08]
01_SolidWorks/3_Anciennes versions/3l_13-11 avant renforts U, patins, pince/Pieces robot/tige pour direction.SLDPRT
65.0 x 8.00 x 8.00 mm
