amauryvandenberghe/Bras-robos/01_SolidWorks/3_Anciennes versions/3l_13-11 avant renforts U, patins, pince/Visserie/Vis 2x8.step

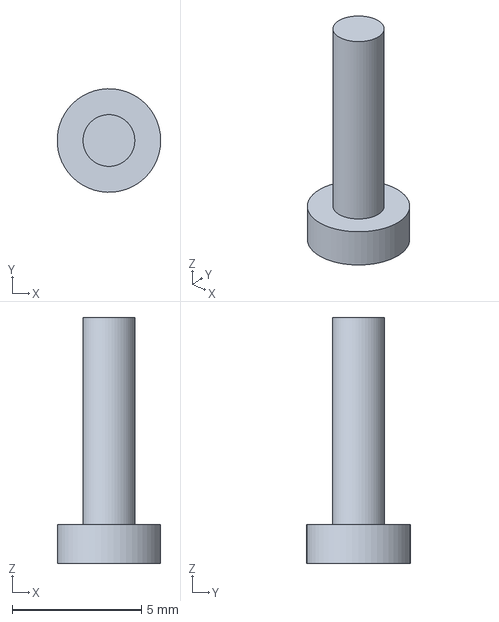
[picture p89: CAD file, 2026-11-08]
01_SolidWorks/3_Anciennes versions/3l_13-11 avant renforts U, patins, pince/Visserie/Vis 2x8.step
4.00 x 4.00 x 9.50 mm
