amauryvandenberghe/Bras-robos/04_Simulation_Gazebo/meshes/bras_trois.stl

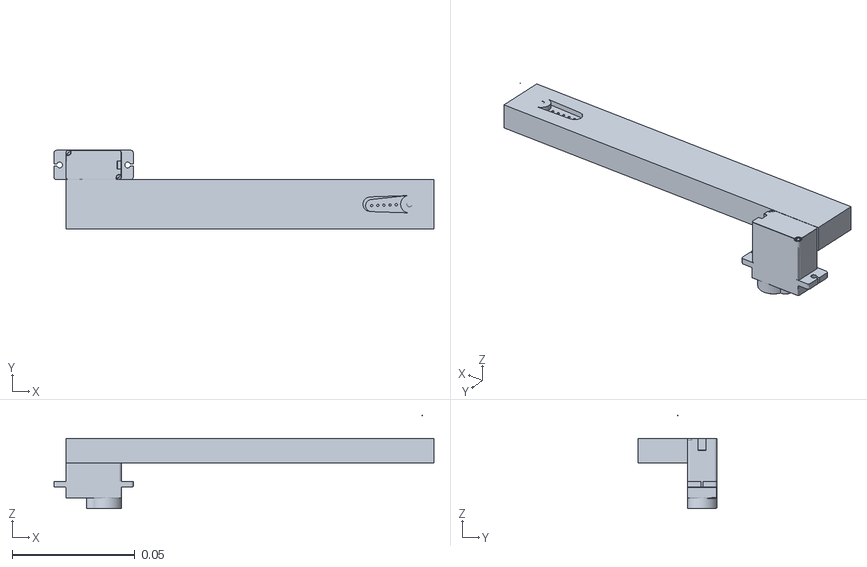
[picture p90: CAD file, 2026-11-08]
04_Simulation_Gazebo/meshes/bras_trois.stl
0.155 x 0.032 x 0.0379
