amauryvandenberghe/Bras-robos/01_SolidWorks/1_VERSION_FINALE (a ouvrir)/Pieces bras/flasque_pince.SLDPRT

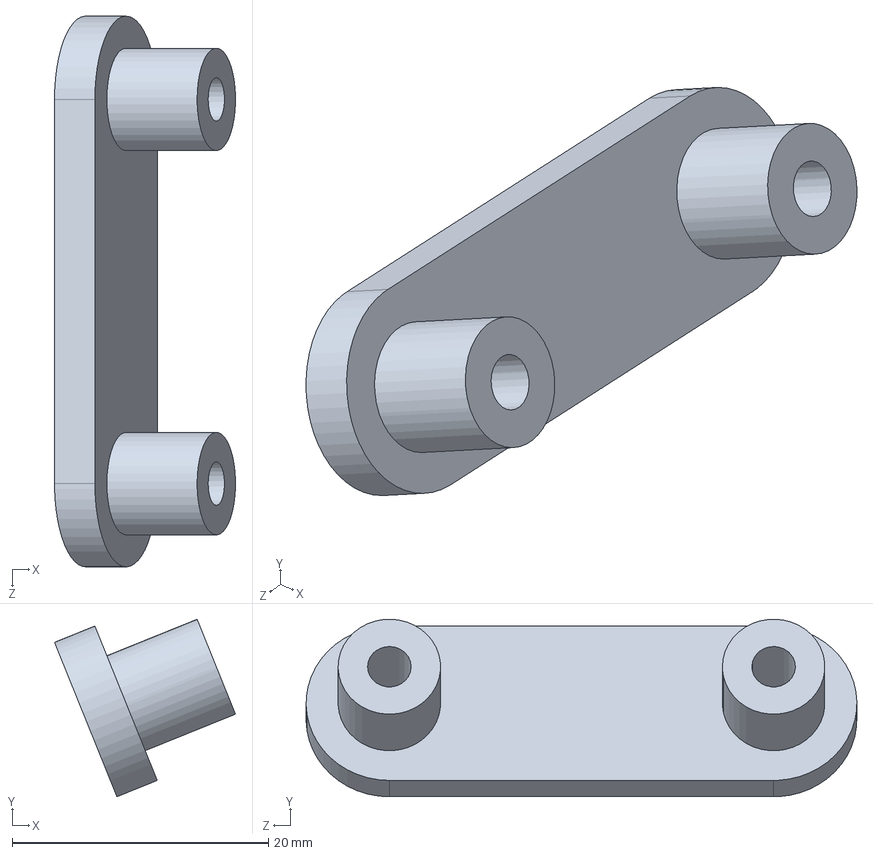
[picture p91: CAD file, 2026-11-13]
01_SolidWorks/1_VERSION_FINALE (a ouvrir)/Pieces bras/flasque_pince.SLDPRT
14.1 x 13.9 x 43.0 mm
