amauryvandenberghe/Bras-robos/01_SolidWorks/2_Pieces d'origine (copies de vos fichiers)/MG996R SERVO/Servo MG996R Shaft.SLDPRT

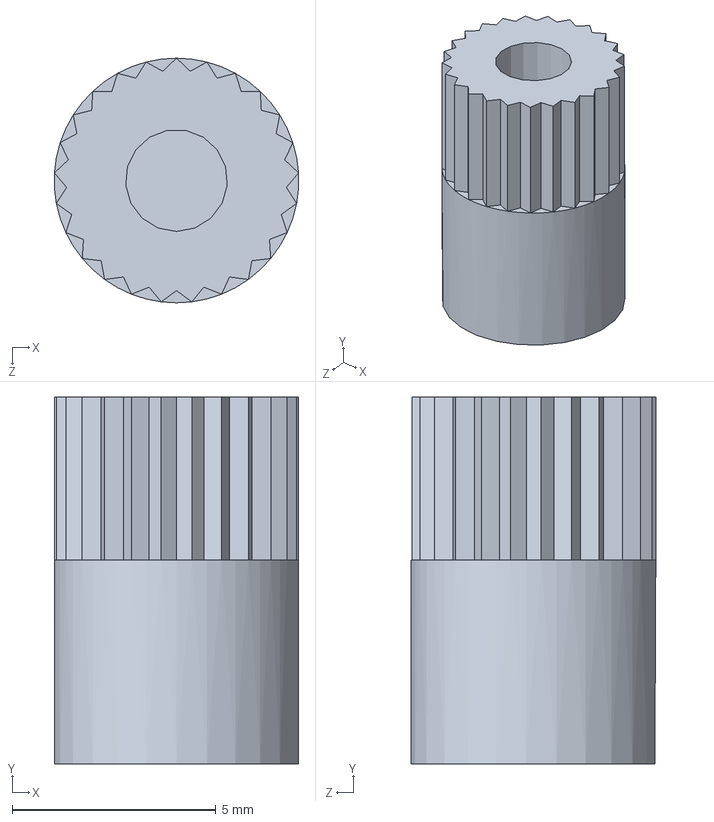
[picture p92: CAD file, 2026-11-08]
01_SolidWorks/2_Pieces d'origine (copies de vos fichiers)/MG996R SERVO/Servo MG996R Shaft.SLDPRT
5.99 x 9.00 x 6.00 mm
