amauryvandenberghe/Bras-robos/01_SolidWorks/3_Anciennes versions/3e_06-11 avant roulements/02_Impression_3D/avant_bras.stl

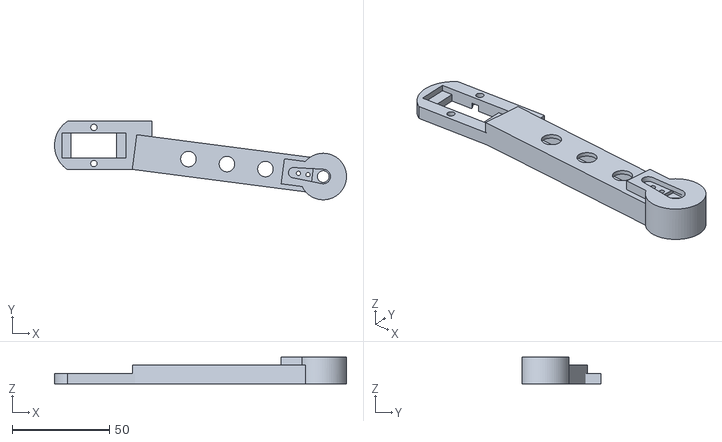
[picture p93: CAD file, 2026-11-08]
01_SolidWorks/3_Anciennes versions/3e_06-11 avant roulements/02_Impression_3D/avant_bras.stl
150.4 x 40.5 x 13.9
