amauryvandenberghe/Bras-robos/01_SolidWorks/3_Anciennes versions/3g_06-11 avec roulements sans visserie/02_Impression_3D/bras.stl

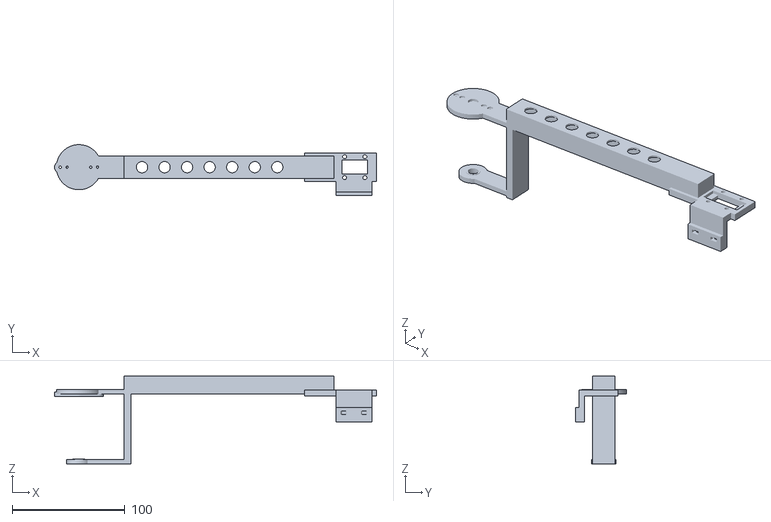
[picture p94: CAD file, 2026-11-08]
01_SolidWorks/3_Anciennes versions/3g_06-11 avec roulements sans visserie/02_Impression_3D/bras.stl
285.6 x 45.0 x 78.0
