amauryvandenberghe/Bras-robos/01_SolidWorks/3_Anciennes versions/3l_13-11 avant renforts U, patins, pince/Pieces robot/pièce moteur direction.SLDPRT

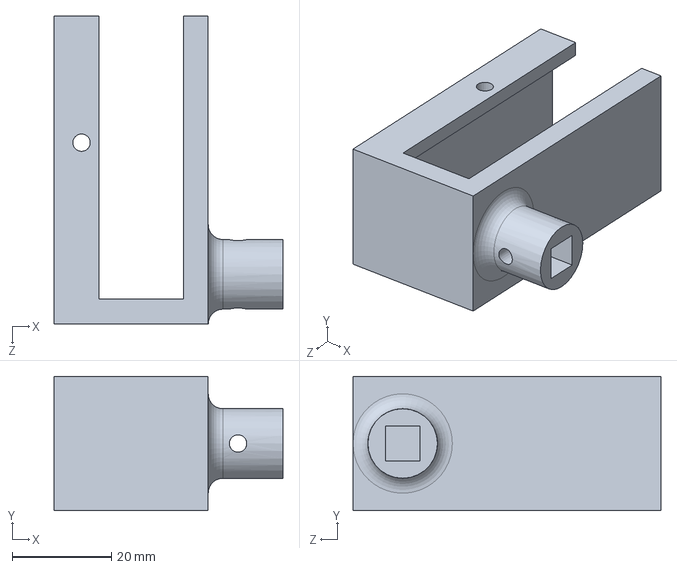
[picture p96: CAD file, 2026-11-08]
01_SolidWorks/3_Anciennes versions/3l_13-11 avant renforts U, patins, pince/Pieces robot/pièce moteur direction.SLDPRT
46.0 x 27.0 x 62.0 mm
