amauryvandenberghe/Bras-robos/04_Simulation_Gazebo/bras_50cm/servos/mg996r_palonnier.step

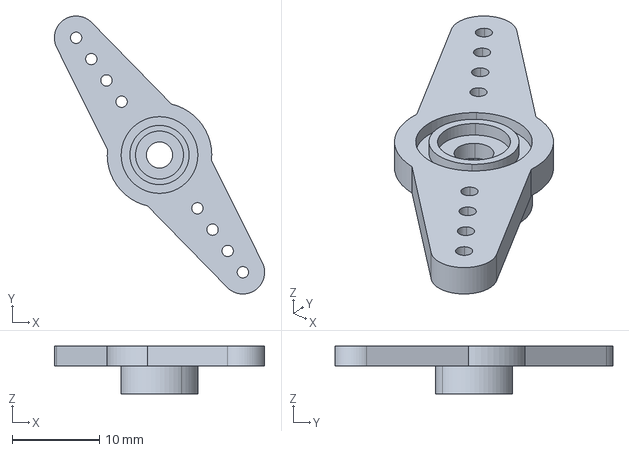
[picture p97: CAD file, 2026-11-08]
04_Simulation_Gazebo/bras_50cm/servos/mg996r_palonnier.step
24.1 x 31.9 x 5.50 mm
