amauryvandenberghe/Bras-robos/04_Simulation_Gazebo/meshes/bras_50cm/coupe_grande.stl

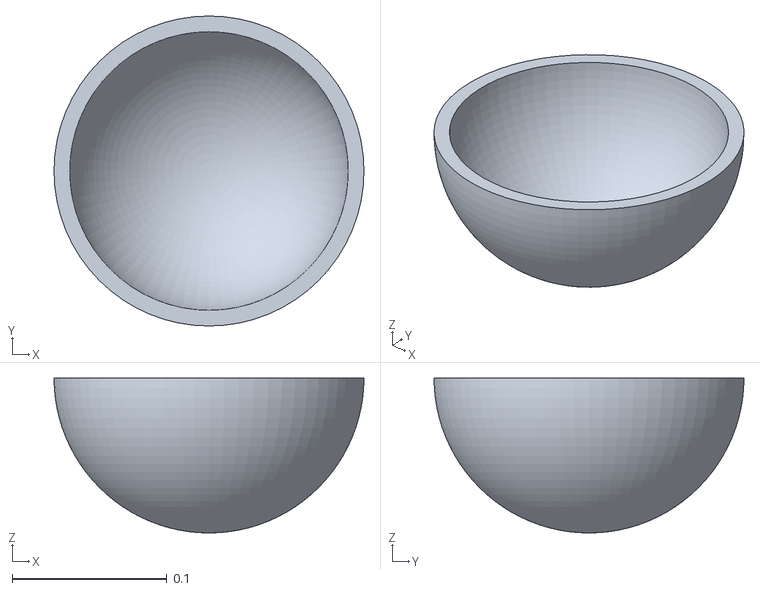
[picture p98: CAD file, 2026-11-08]
04_Simulation_Gazebo/meshes/bras_50cm/coupe_grande.stl
0.2 x 0.2 x 0.1
