amauryvandenberghe/Bras-robos/04_Simulation_Gazebo/meshes/vis_deux_4.stl

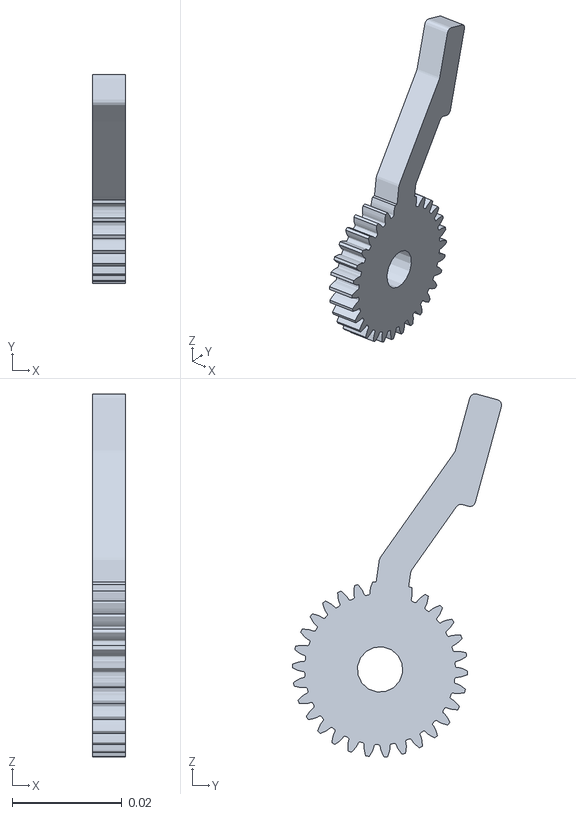
[picture p99: CAD file, 2026-11-08]
04_Simulation_Gazebo/meshes/vis_deux_4.stl
0.006 x 0.0382 x 0.0663
