amauryvandenberghe/Bras-robos/01_SolidWorks/1_VERSION_FINALE (a ouvrir)/Pieces bras/plateau.SLDPRT

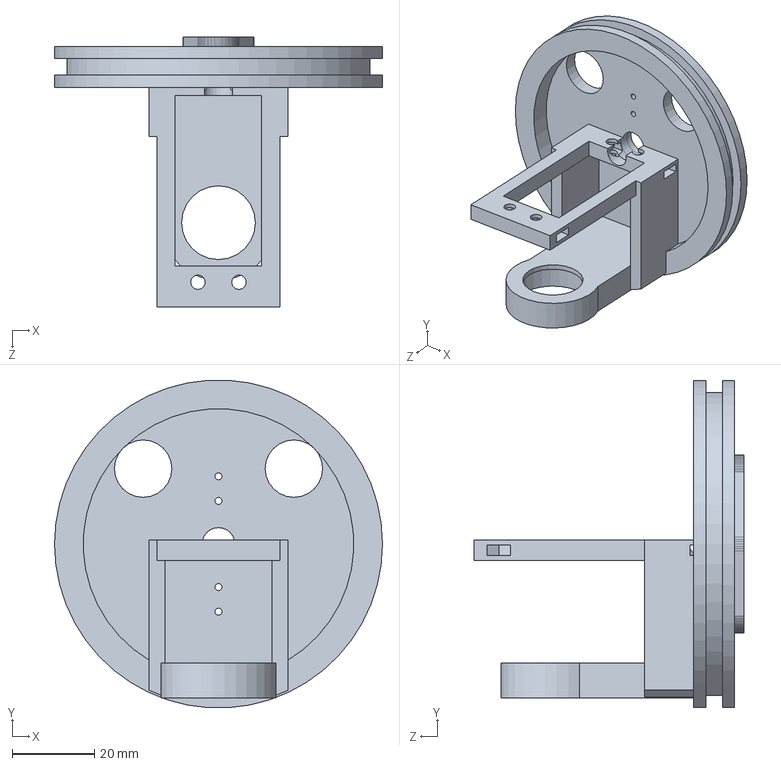
[picture p100: CAD file, 2026-11-13]
01_SolidWorks/1_VERSION_FINALE (a ouvrir)/Pieces bras/plateau.SLDPRT
80.0 x 79.8 x 65.9 mm
