amauryvandenberghe/Bras-robos/01_SolidWorks/3_Anciennes versions/3e_06-11 avant roulements/02_Impression_3D/corps_pince.stl

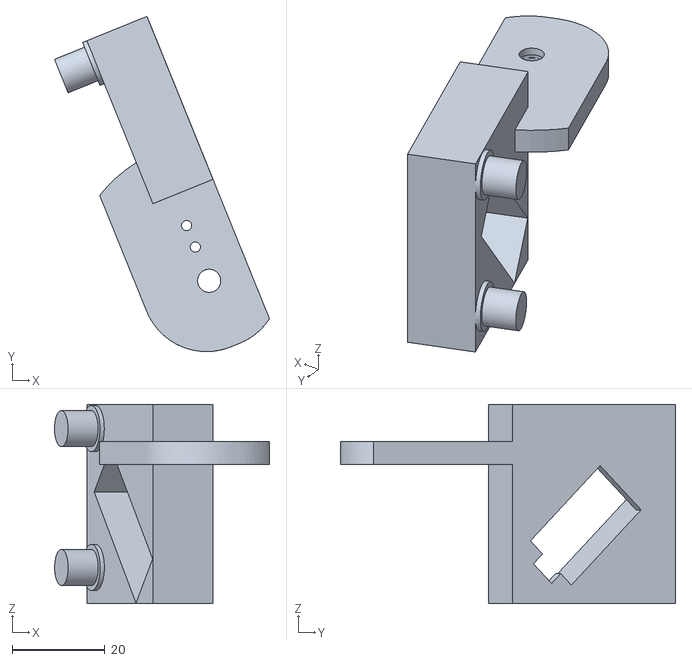
[picture p101: CAD file, 2026-11-08]
01_SolidWorks/3_Anciennes versions/3e_06-11 avant roulements/02_Impression_3D/corps_pince.stl
46.5 x 72.4 x 43.0
