amauryvandenberghe/Bras-robos/01_SolidWorks/3_Anciennes versions/3l_13-11 avant renforts U, patins, pince/Pieces robot/mcc.SLDPRT

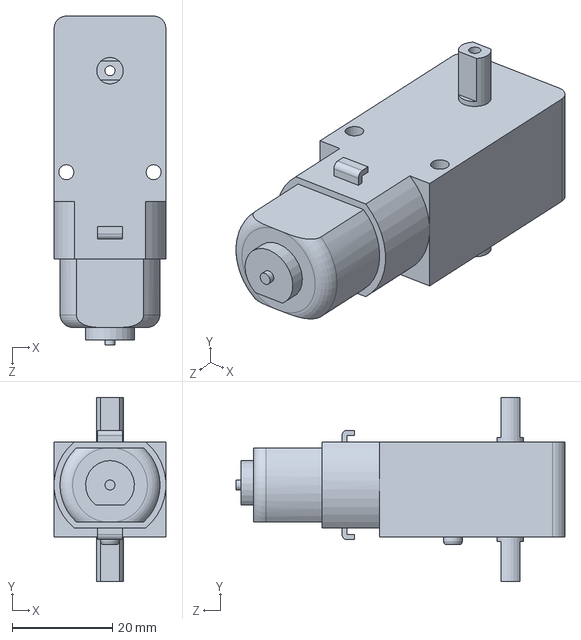
[picture p103: CAD file, 2026-11-08]
01_SolidWorks/3_Anciennes versions/3l_13-11 avant renforts U, patins, pince/Pieces robot/mcc.SLDPRT
22.3 x 36.8 x 65.7 mm
