amauryvandenberghe/Bras-robos/04_Simulation_Gazebo/bras_50cm/servos/arm01.step

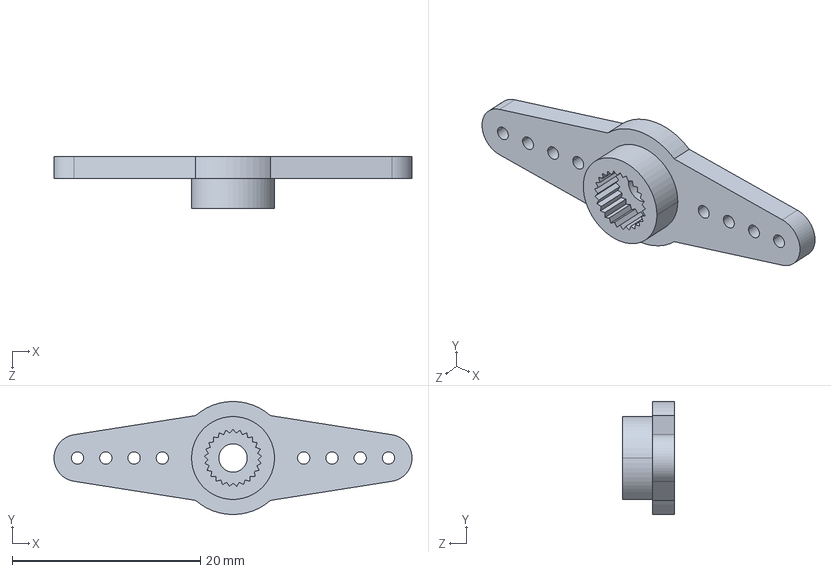
[picture p104: CAD file, 2026-11-08]
04_Simulation_Gazebo/bras_50cm/servos/arm01.step
38.0 x 12.0 x 5.50 mm
