amauryvandenberghe/Bras-robos/04_Simulation_Gazebo/meshes/bras_quatre.stl

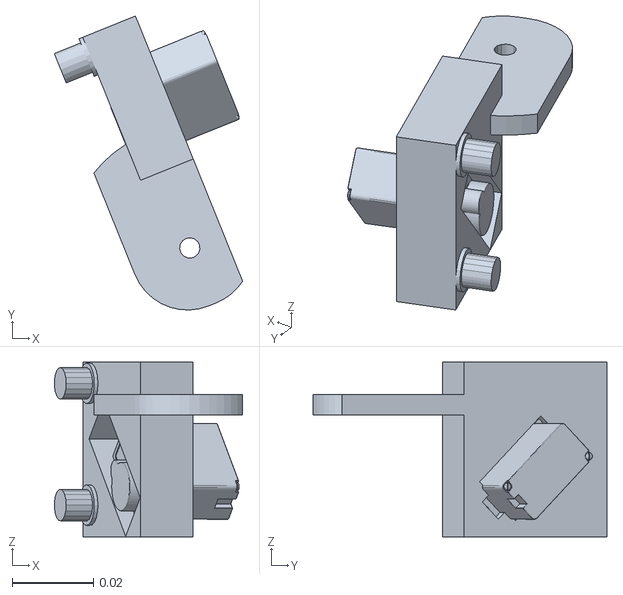
[picture p105: CAD file, 2026-11-08]
04_Simulation_Gazebo/meshes/bras_quatre.stl
0.0464 x 0.0724 x 0.043
