amauryvandenberghe/Bras-robos/01_SolidWorks/2_Pieces d'origine (copies de vos fichiers)/pince.SLDPRT

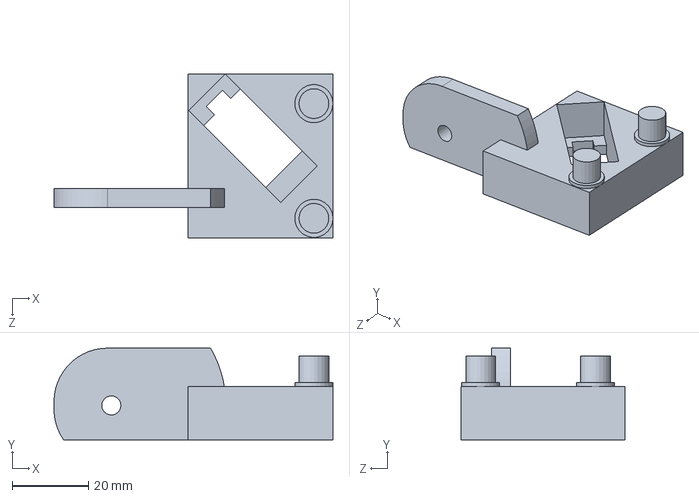
[picture p106: CAD file, 2026-11-08]
01_SolidWorks/2_Pieces d'origine (copies de vos fichiers)/pince.SLDPRT
73.0 x 24.0 x 43.0 mm
