amauryvandenberghe/Bras-robos/01_SolidWorks/3_Anciennes versions/3e_06-11 avant roulements/02_Impression_3D/socle.stl

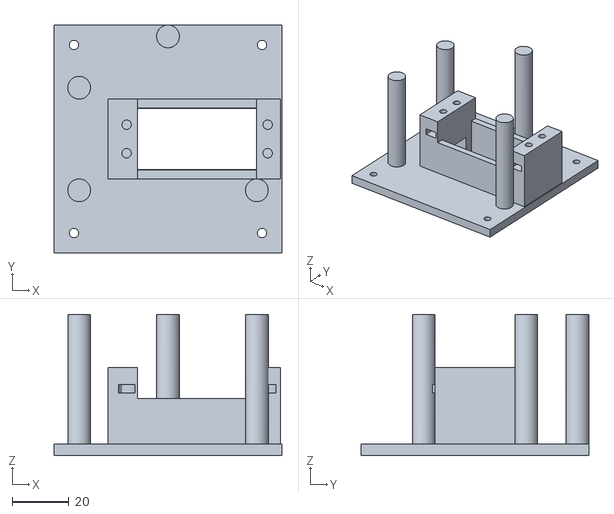
[picture p107: CAD file, 2026-11-08]
01_SolidWorks/3_Anciennes versions/3e_06-11 avant roulements/02_Impression_3D/socle.stl
80.0 x 80.0 x 49.5
