amauryvandenberghe/Bras-robos/01_SolidWorks/3_Anciennes versions/3h_07-11 avant servo de pince droit et support capteurs/bride_coude.step

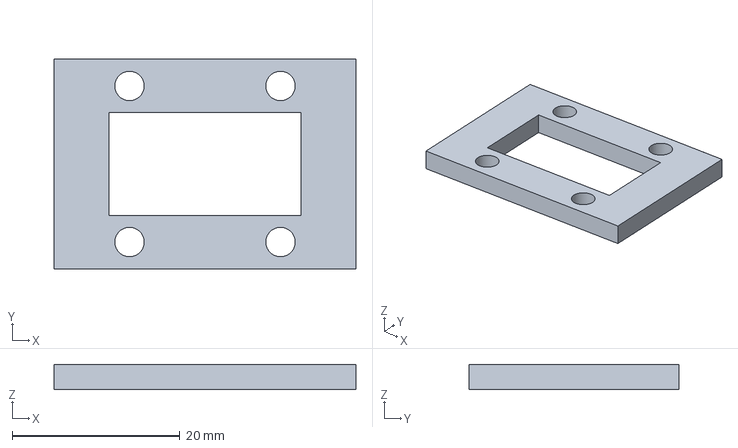
[picture p109: CAD file, 2026-11-08]
01_SolidWorks/3_Anciennes versions/3h_07-11 avant servo de pince droit et support capteurs/bride_coude.step
36.0 x 25.0 x 3.00 mm
