amauryvandenberghe/Bras-robos/01_SolidWorks/3_Anciennes versions/3l_13-11 avant renforts U, patins, pince/Pieces robot/roue arriere motrice.SLDPRT

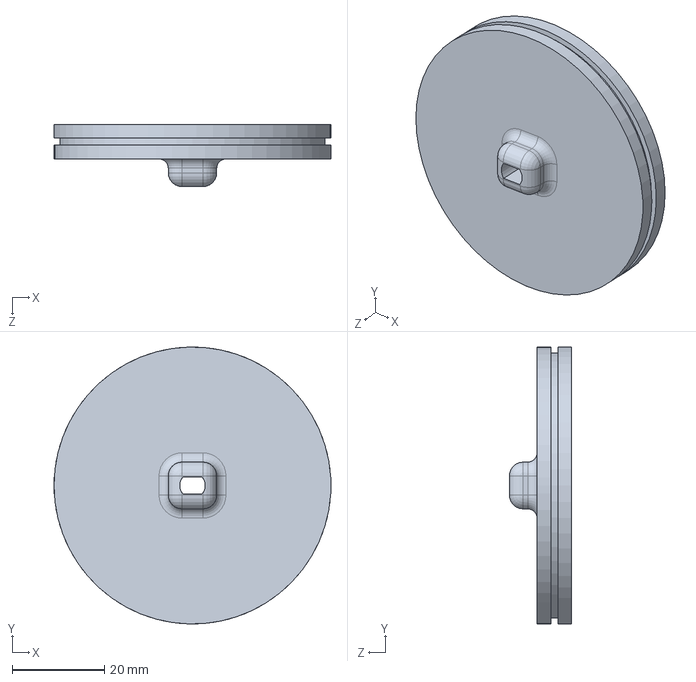
[picture p111: CAD file, 2026-11-08]
01_SolidWorks/3_Anciennes versions/3l_13-11 avant renforts U, patins, pince/Pieces robot/roue arriere motrice.SLDPRT
60.0 x 60.0 x 13.5 mm
