amauryvandenberghe/Bras-robos/01_SolidWorks/3_Anciennes versions/3l_13-11 avant renforts U, patins, pince/Visserie/Vis M3x12.step

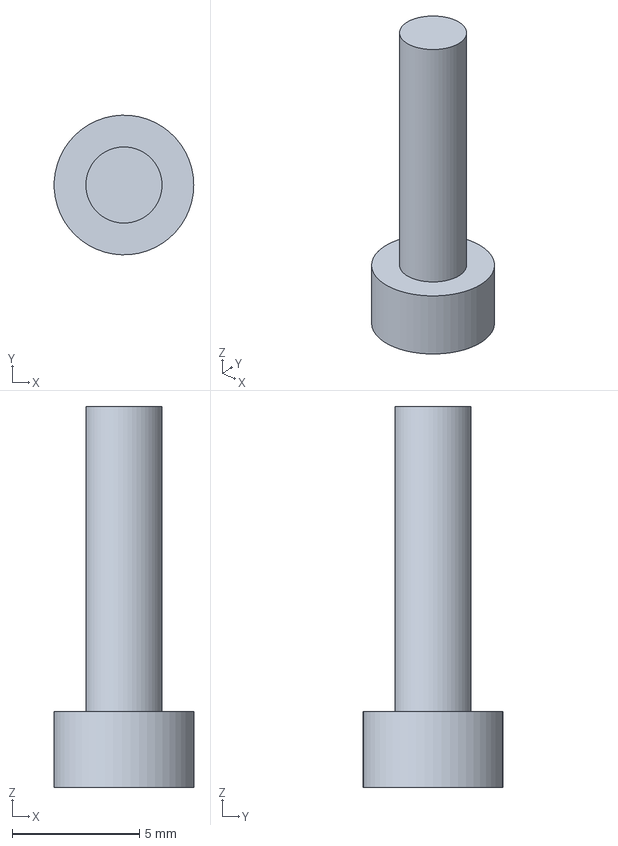
[picture p112: CAD file, 2026-11-08]
01_SolidWorks/3_Anciennes versions/3l_13-11 avant renforts U, patins, pince/Visserie/Vis M3x12.step
5.49 x 5.50 x 15.0 mm
