amauryvandenberghe/Bras-robos/04_Simulation_Gazebo/meshes/bras_50cm/coupe_petite.stl

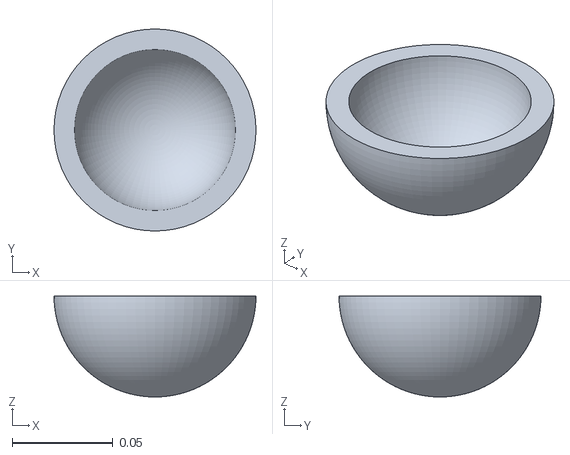
[picture p113: CAD file, 2026-11-08]
04_Simulation_Gazebo/meshes/bras_50cm/coupe_petite.stl
0.1 x 0.1 x 0.05
