amauryvandenberghe/Bras-robos/01_SolidWorks/2_Pieces d'origine (copies de vos fichiers)/support 2.SLDPRT

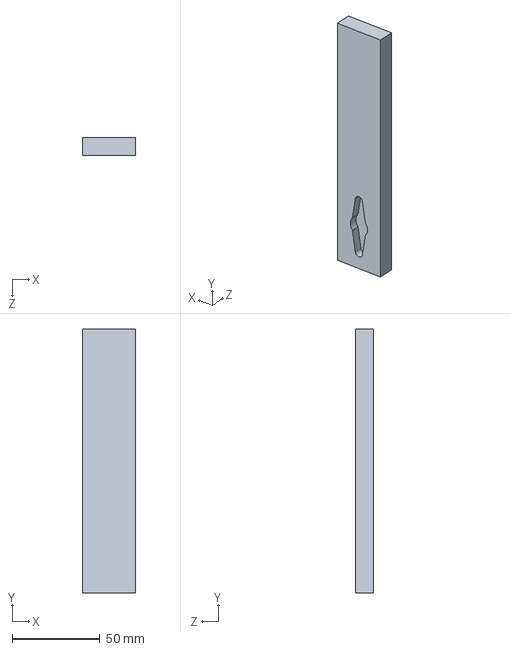
[picture p114: CAD file, 2026-11-08]
01_SolidWorks/2_Pieces d'origine (copies de vos fichiers)/support 2.SLDPRT
30.0 x 150.0 x 10.0 mm
