amauryvandenberghe/Bras-robos/01_SolidWorks/3_Anciennes versions/3h_07-11 avant servo de pince droit et support capteurs/axe_epaule.step

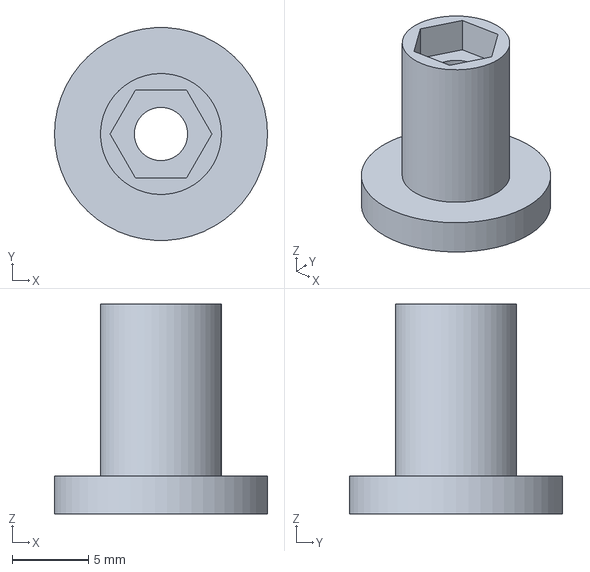
[picture p115: CAD file, 2026-11-08]
01_SolidWorks/3_Anciennes versions/3h_07-11 avant servo de pince droit et support capteurs/axe_epaule.step
14.0 x 14.0 x 13.8 mm
