amauryvandenberghe/Bras-robos/01_SolidWorks/3_Anciennes versions/3k_08-11 etat avant rangement final/1_ASSEMBLAGE_FINAL (a utiliser)/Rondelle M3.SLDPRT

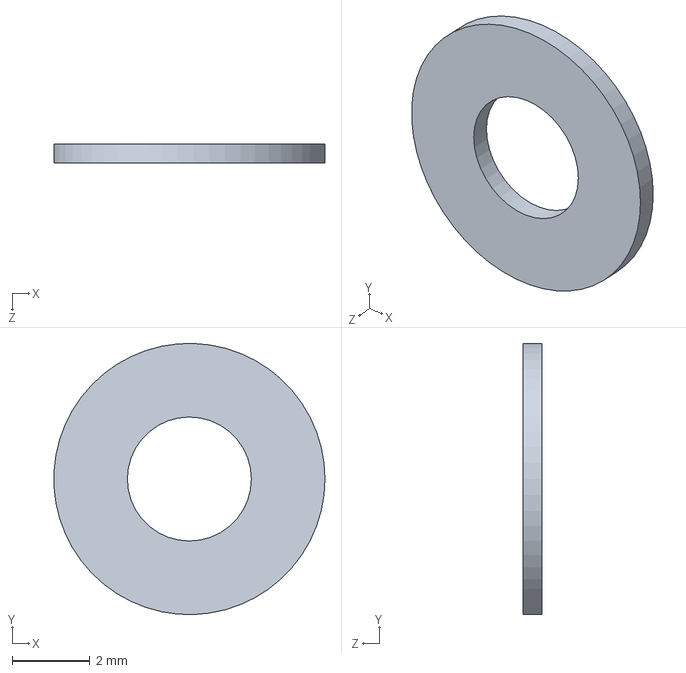
[picture p116: CAD file, 2026-11-08]
01_SolidWorks/3_Anciennes versions/3k_08-11 etat avant rangement final/1_ASSEMBLAGE_FINAL (a utiliser)/Rondelle M3.SLDPRT
6.99 x 7.00 x 0.5 mm
