amauryvandenberghe/Bras-robos/01_SolidWorks/3_Anciennes versions/3l_13-11 avant renforts U, patins, pince/Pieces robot/maitient roulement a bille.SLDPRT

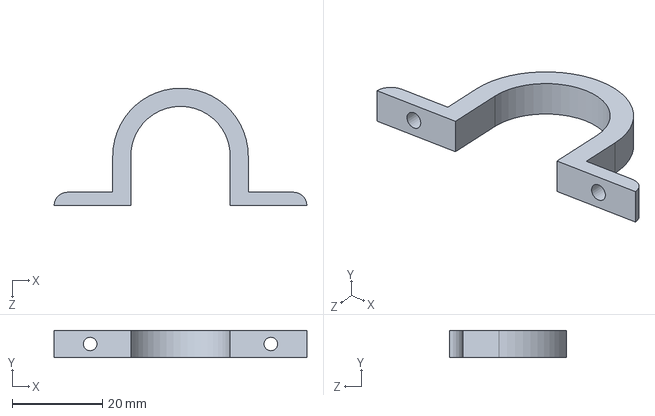
[picture p117: CAD file, 2026-11-08]
01_SolidWorks/3_Anciennes versions/3l_13-11 avant renforts U, patins, pince/Pieces robot/maitient roulement a bille.SLDPRT
56.0 x 6.00 x 26.0 mm
