amauryvandenberghe/Bras-robos/01_SolidWorks/1_VERSION_FINALE (a ouvrir)/Pieces bras/corps_pince.SLDPRT

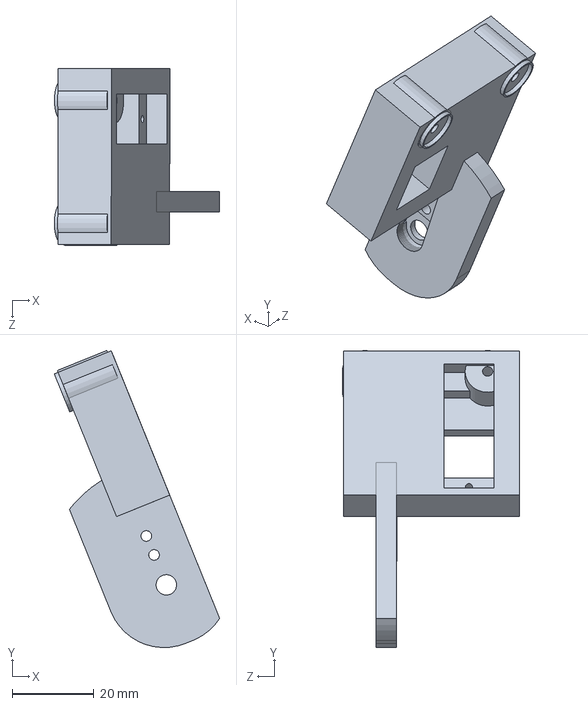
[picture p118: CAD file, 2026-11-13]
01_SolidWorks/1_VERSION_FINALE (a ouvrir)/Pieces bras/corps_pince.SLDPRT
40.4 x 72.5 x 43.3 mm
