amauryvandenberghe/Bras-robos/01_SolidWorks/3_Anciennes versions/3l_13-11 avant renforts U, patins, pince/Visserie/Ecrou M3.step

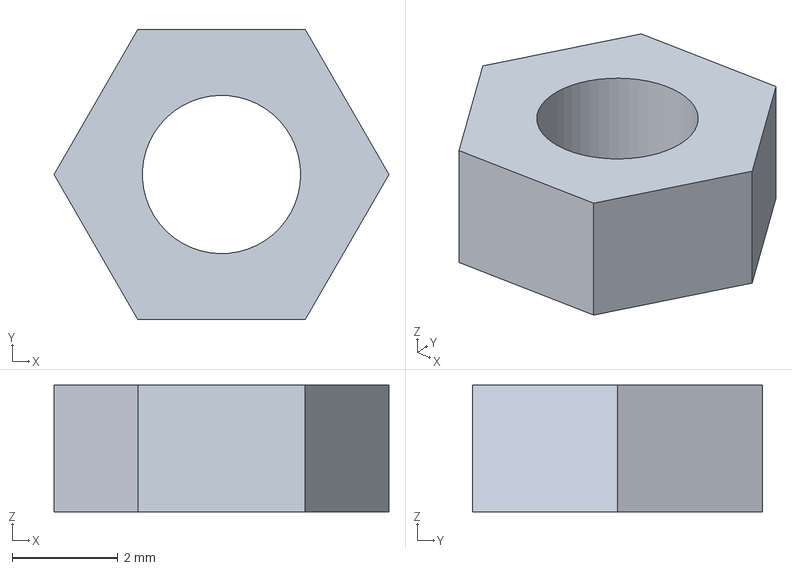
[picture p122: CAD file, 2026-11-08]
01_SolidWorks/3_Anciennes versions/3l_13-11 avant renforts U, patins, pince/Visserie/Ecrou M3.step
6.35 x 5.50 x 2.40 mm
