amauryvandenberghe/Bras-robos/02_Impression_3D/machoire_b.STL

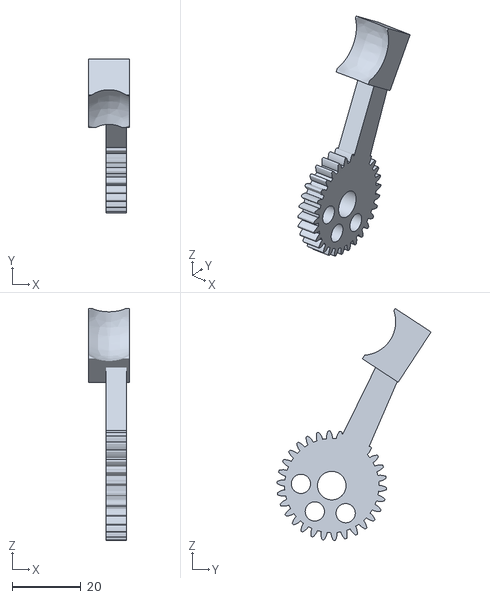
[picture p123: CAD file, 2026-11-13]
02_Impression_3D/machoire_b.STL
12.0 x 44.9 x 67.6
