amauryvandenberghe/Bras-robos/01_SolidWorks/2_Pieces d'origine (copies de vos fichiers)/support1.SLDPRT

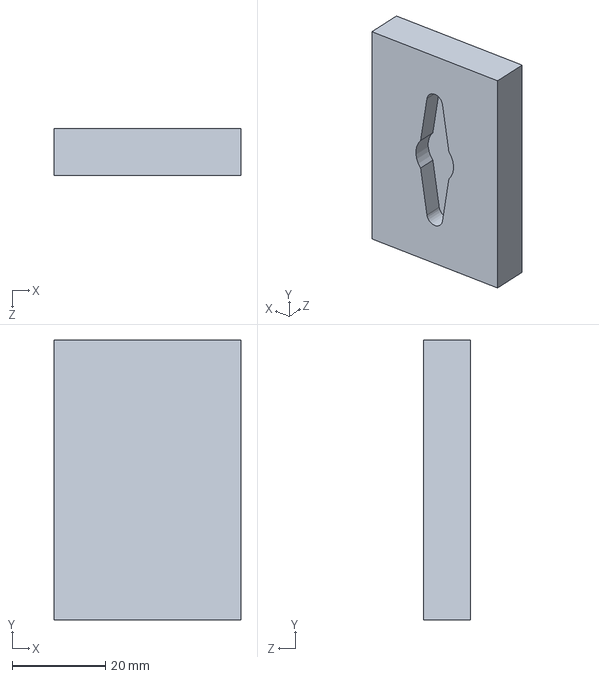
[picture p124: CAD file, 2026-11-08]
01_SolidWorks/2_Pieces d'origine (copies de vos fichiers)/support1.SLDPRT
40.0 x 60.0 x 10.0 mm
