amauryvandenberghe/Bras-robos/01_SolidWorks/3_Anciennes versions/3l_13-11 avant renforts U, patins, pince/Pieces robot/L298N Motor Driver.step.SLDPRT

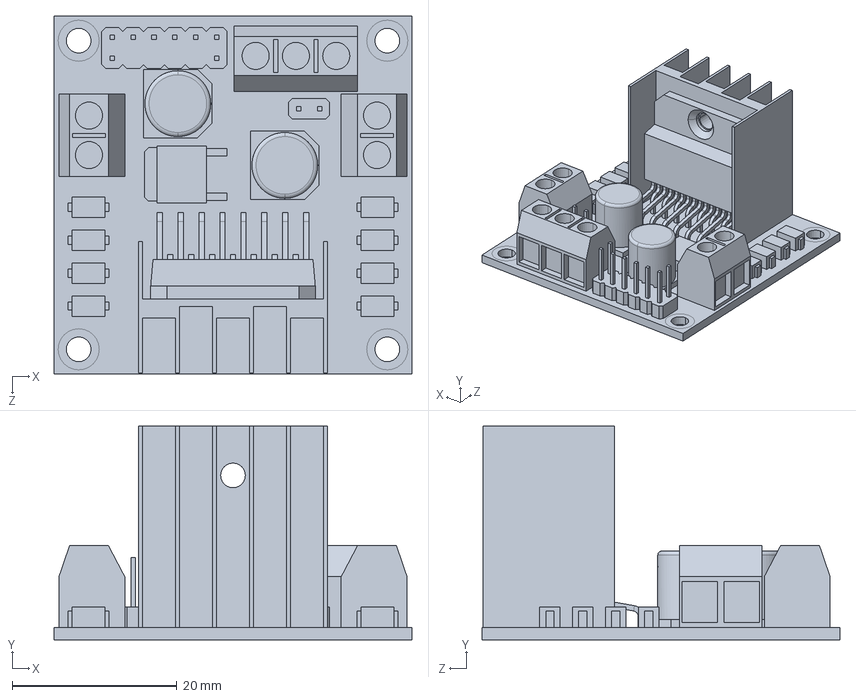
[picture p127: CAD file, 2026-11-08]
01_SolidWorks/3_Anciennes versions/3l_13-11 avant renforts U, patins, pince/Pieces robot/L298N Motor Driver.step.SLDPRT
43.5 x 26.0 x 43.5 mm
