amauryvandenberghe/Bras-robos/02_Impression_3D/corps_pince.stl

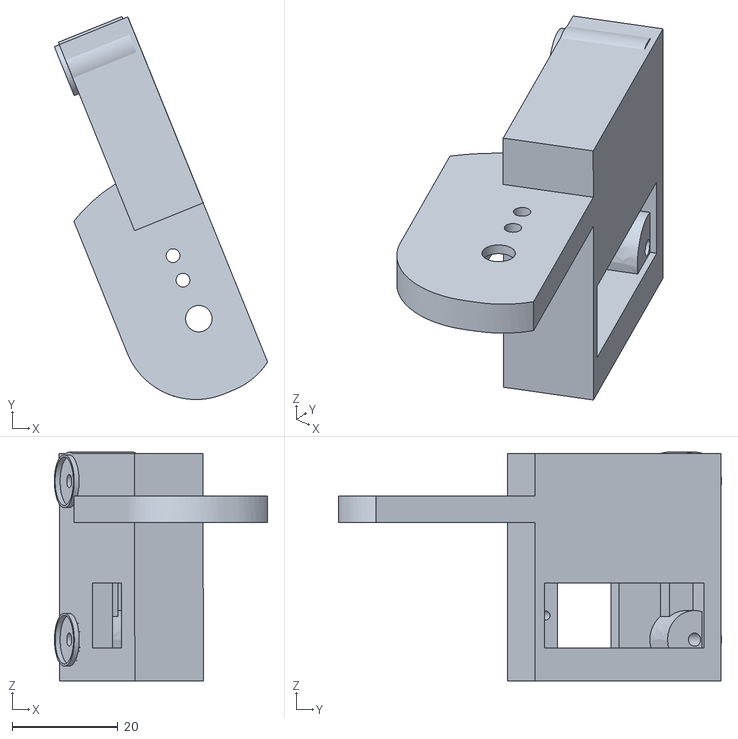
[picture p129: CAD file, 2026-11-13]
02_Impression_3D/corps_pince.stl
40.4 x 72.5 x 43.3
