amauryvandenberghe/Bras-robos/01_SolidWorks/2_Pieces d'origine (copies de vos fichiers)/support 3.SLDPRT

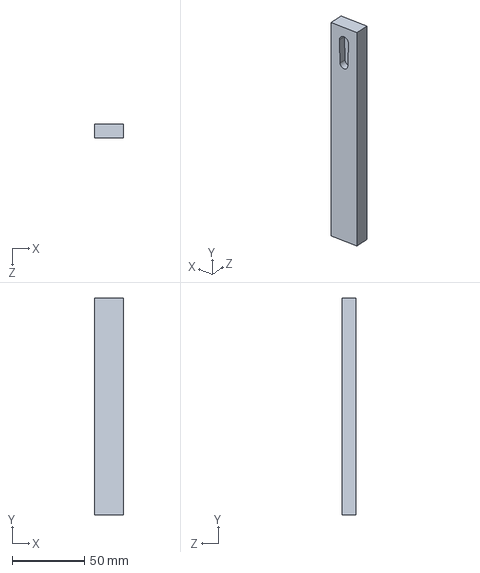
[picture p130: CAD file, 2026-11-08]
01_SolidWorks/2_Pieces d'origine (copies de vos fichiers)/support 3.SLDPRT
20.0 x 150.0 x 10.0 mm
