amauryvandenberghe/Bras-robos/01_SolidWorks/3_Anciennes versions/3a_premiere version sans contraintes/Bras 50cm.SLDASM

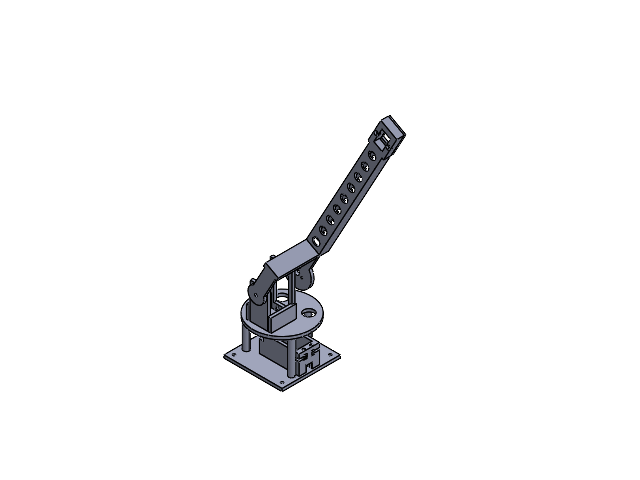
[picture p133: CAD file, 2026-11-08]
01_SolidWorks/3_Anciennes versions/3a_premiere version sans contraintes/Bras 50cm.SLDASM
socle
plateau
bras
bride_coude
