amauryvandenberghe/Bras-robos/01_SolidWorks/1_VERSION_FINALE (a ouvrir)/Bras 50cm.SLDASM

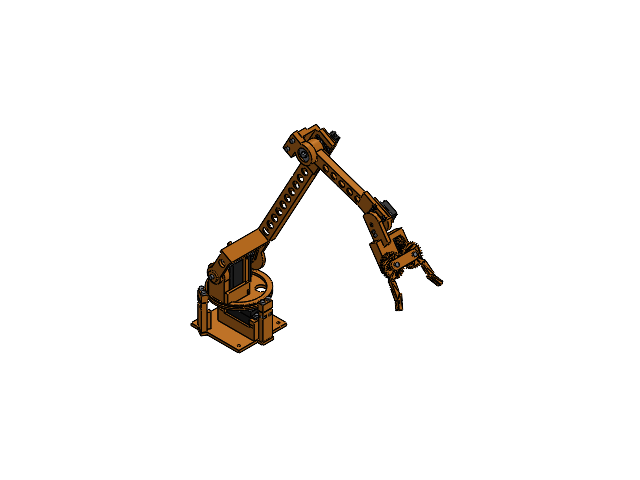
[picture p138: CAD file, 2026-11-13]
01_SolidWorks/1_VERSION_FINALE (a ouvrir)/Bras 50cm.SLDASM
socle
plateau
bras
bride_coude
avant_bras
bride_poignet
corps_pince
palier_coude
axe_epaule
patin_a
patin_b
patin_c
pignon_pince
machoire_a
machoire_b
Servo MG996R x 2
Servo MG90S x 3
Servo MG996R arm01 x 2
broche x 2
Roulement 608 x 2
Vis M3x12 x 4
Ecrou M3 x 26
Vis M3x8 x 12
Vis M3x16 x 4
Rondelle M3
Vis M3x20 x 8
Vis 2x8 x 14
flasque_pince
