amauryvandenberghe/Bras-robos/01_SolidWorks/3_Anciennes versions/3b_28-10 sans servos/Bras 50cm.SLDASM

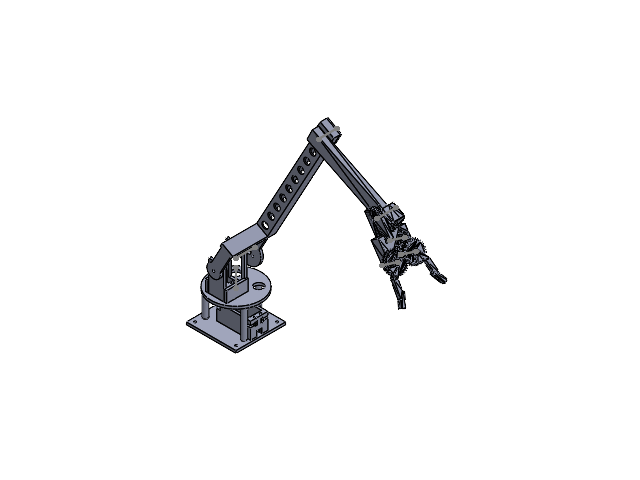
[picture p140: CAD file, 2026-11-08]
01_SolidWorks/3_Anciennes versions/3b_28-10 sans servos/Bras 50cm.SLDASM
socle
plateau
bras
bride_coude
avant_bras
corps_pince
pignon_pince
machoire_a
machoire_b
