amauryvandenberghe/Bras-robos/01_SolidWorks/3_Anciennes versions/3c_29-10 sans empreintes de palonniers/Bras 50cm.SLDASM

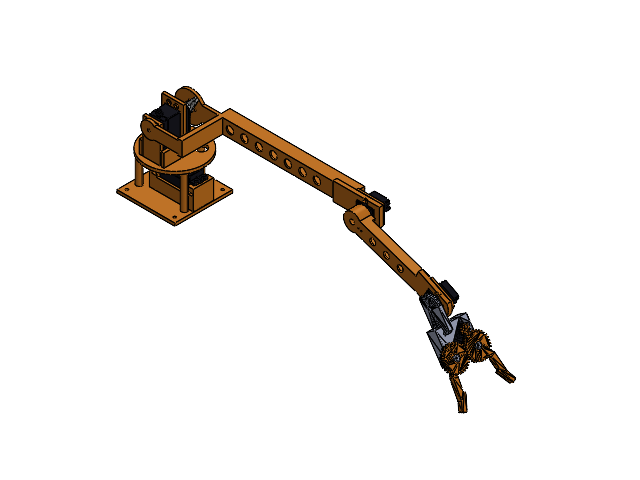
[picture p141: CAD file, 2026-11-08]
01_SolidWorks/3_Anciennes versions/3c_29-10 sans empreintes de palonniers/Bras 50cm.SLDASM
socle
plateau
bras
bride_coude
avant_bras
bride_poignet
corps_pince
pignon_pince
machoire_a
machoire_b
Servo MG996R x 2
Servo MG90S x 3
Palonnier MG996R x 2
