amauryvandenberghe/Bras-robos/01_SolidWorks/3_Anciennes versions/3l_13-11 avant renforts U, patins, pince/Pieces robot/capteur.SLDASM

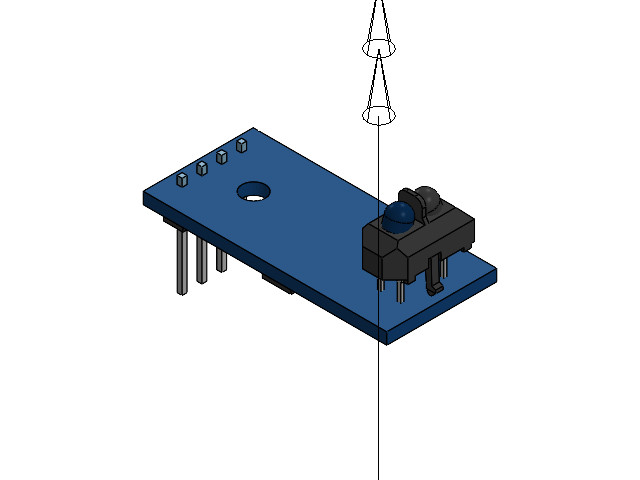
[picture p142: CAD file, 2026-11-08]
01_SolidWorks/3_Anciennes versions/3l_13-11 avant renforts U, patins, pince/Pieces robot/capteur.SLDASM
Metal Contacts.step
Metal Contacts-0.step
TCRT5000 v1.step
LEDs.step
LEDs-1.step
Metal Contacts-2.step
Metal Contacts-3.step
Part 1.step
