amauryvandenberghe/Bras-robos/01_SolidWorks/3_Anciennes versions/3h_07-11 avant servo de pince droit et support capteurs/Assemblage1v2.SLDASM

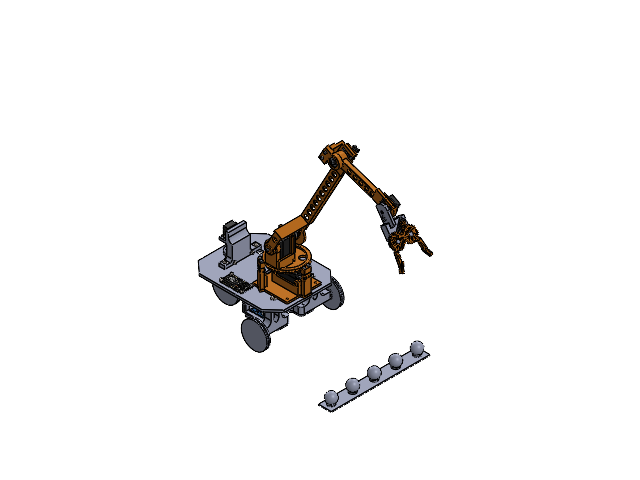
[picture p143: CAD file, 2026-11-08]
01_SolidWorks/3_Anciennes versions/3h_07-11 avant servo de pince droit et support capteurs/Assemblage1v2.SLDASM
maitient roulement a bille
piece de liason servo moteur tige
pièce moteur direction
Body.step
Shaft.step
Horn.step
Screw.step
support servo moteur direction
tige pour direction
roue arriere motrice x 2
roulement à bille x 3
piece avec les bites
roue avant libre x 2
mcc
bati(en cours)
BUTTONFLASH-13_2.stp x 2
BUTTONFLASH-14_2.stp x 2
PCB.stp
PIN.stp x 30
WIFI_CARD_2.stp
RECTANGULARCHIP_2.stp
MICROCHIP_2.stp
TANCHIP_2.stp
TRANSISTOR_3-LEG_2.stp
RESISTOR1_2.stp x 11
RESISTOR2-32_2.stp x 2
TRANSISTOR_3-LEG2_2.stp
USB_SOCKET_2.stp
L298N Motor Driver.step
socket head cap screw_iso x 25
hex nut style 1 gradeab_iso x 22
plain washer large grade ac_iso x 10
balle x 5
socle balle
Metal Contacts.step x 3
Metal Contacts-0.step x 3
TCRT5000 v1.step x 3
LEDs.step x 3
LEDs-1.step x 3
Metal Contacts-2.step x 3
Metal Contacts-3.step x 3
Part 1.step x 3
support capteur
socle
plateau
bras
bride_coude
avant_bras
bride_poignet
corps_pince
palier_coude
axe_epaule
patin_a
patin_b
patin_c
pignon_pince
machoire_a
machoire_b
Servo MG996R x 2
Servo MG90S x 3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
