amauryvandenberghe/Bras-robos/(list of files, cad)

Other CAD files:
01_SolidWorks/2_Pieces d'origine (copies de vos fichiers)/pince_a_imprimer_deux_fois.SLDASM
01_SolidWorks/3_Anciennes versions/3l_13-11 avant renforts U, patins, pince/Assemblage1v2.SLDASM
01_SolidWorks/2_Pieces d'origine (copies de vos fichiers)/petit engrenage pince.SLDASM
01_SolidWorks/3_Anciennes versions/3k_08-11 etat avant rangement final/1_ASSEMBLAGE_FINAL (a utiliser)/Bras 50cm.SLDASM
01_SolidWorks/3_Anciennes versions/3e_06-11 avant roulements/Bras 50cm.SLDASM
01_SolidWorks/3_Anciennes versions/3c_29-10 sans empreintes de palonniers/Servo MG996R.step
01_SolidWorks/3_Anciennes versions/3l_13-11 avant renforts U, patins, pince/Pieces bras/patin_a.step
04_Simulation_Gazebo/bras_50cm/servos/mg996r_origine.step
01_SolidWorks/2_Pieces d'origine (copies de vos fichiers)/MG996R SERVO/Servo MG996R.SLDPRT
01_SolidWorks/3_Anciennes versions/3e_06-11 avant roulements/02_Impression_3D/bride_coude.stl
01_SolidWorks/3_Anciennes versions/3h_07-11 avant servo de pince droit et support capteurs/Servo MG996R.SLDPRT
01_SolidWorks/3_Anciennes versions/3l_13-11 avant renforts U, patins, pince/Impression/patin_c.stl
01_SolidWorks/3_Anciennes versions/3l_13-11 avant renforts U, patins, pince/Pieces bras/broche.SLDPRT
02_Impression_3D/machoire_a.STL
04_Simulation_Gazebo/bras_50cm/servos/mg996r_corps.step
04_Simulation_Gazebo/meshes/bras_50cm/socle.stl
01_SolidWorks/3_Anciennes versions/3a_premiere version sans contraintes/bride_coude.step
01_SolidWorks/3_Anciennes versions/3h_07-11 avant servo de pince droit et support capteurs/Servo MG90S.SLDPRT
01_SolidWorks/3_Anciennes versions/3l_13-11 avant renforts U, patins, pince/Pieces bras/socle.step
02_Impression_3D/flasque_pince.stl
01_SolidWorks/3_Anciennes versions/3a_premiere version sans contraintes/plateau.step
01_SolidWorks/3_Anciennes versions/3h_07-11 avant servo de pince droit et support capteurs/bride_poignet.step
01_SolidWorks/3_Anciennes versions/3l_13-11 avant renforts U, patins, pince/Pieces bras/bride_poignet.step
02_Impression_3D/patin_c.stl
04_Simulation_Gazebo/meshes/bras_50cm/bras.stl
01_SolidWorks/1_VERSION_FINALE (a ouvrir)/Pieces bras/bras.SLDPRT
01_SolidWorks/3_Anciennes versions/3c_29-10 sans empreintes de palonniers/Servo MG90S.step
01_SolidWorks/3_Anciennes versions/3l_13-11 avant renforts U, patins, pince/Pieces bras/bras.step
02_Impression_3D/patin_b.stl
04_Simulation_Gazebo/bras_50cm/servos/mg90s.step
01_SolidWorks/1_VERSION_FINALE (a ouvrir)/Pieces bras/patin_a.SLDPRT
01_SolidWorks/3_Anciennes versions/3e_06-11 avant roulements/02_Impression_3D/bride_poignet.stl
01_SolidWorks/3_Anciennes versions/3g_06-11 avec roulements sans visserie/02_Impression_3D/bride_coude.stl
01_SolidWorks/3_Anciennes versions/3l_13-11 avant renforts U, patins, pince/Impression/axe_epaule.stl
01_SolidWorks/3_Anciennes versions/3l_13-11 avant renforts U, patins, pince/Pieces bras/machoire_a.step
01_SolidWorks/3_Anciennes versions/3l_13-11 avant renforts U, patins, pince/Visserie/Rondelle M3.step
02_Impression_3D/plateau.stl
04_Simulation_Gazebo/bras_50cm/servos/pince_origine.step
01_SolidWorks/2_Pieces d'origine (copies de vos fichiers)/broche.SLDPRT
01_SolidWorks/3_Anciennes versions/3g_06-11 avec roulements sans visserie/02_Impression_3D/socle.stl
01_SolidWorks/3_Anciennes versions/3h_07-11 avant servo de pince droit et support capteurs/machoire_a.step
01_SolidWorks/3_Anciennes versions/3l_13-11 avant renforts U, patins, pince/Pieces robot/piece avec les bites.SLDPRT
04_Simulation_Gazebo/bras_50cm/servos/broche.step
01_SolidWorks/1_VERSION_FINALE (a ouvrir)/Pieces bras/patin_c.SLDPRT
01_SolidWorks/3_Anciennes versions/3g_06-11 avec roulements sans visserie/02_Impression_3D/bride_poignet.stl
01_SolidWorks/3_Anciennes versions/3h_07-11 avant servo de pince droit et support capteurs/Ecrou M3.step
01_SolidWorks/1_VERSION_FINALE (a ouvrir)/Pieces bras/machoire_b.SLDPRT
01_SolidWorks/3_Anciennes versions/3h_07-11 avant servo de pince droit et support capteurs/avant_bras.step
01_SolidWorks/3_Anciennes versions/3k_08-11 etat avant rangement final/1_ASSEMBLAGE_FINAL (a utiliser)/Vis M3x16.SLDPRT
01_SolidWorks/3_Anciennes versions/3l_13-11 avant renforts U, patins, pince/Pieces bras/bride_coude.step
02_Impression_3D/axe_epaule.stl
01_SolidWorks/3_Anciennes versions/3h_07-11 avant servo de pince droit et support capteurs/Vis 2x8.step
01_SolidWorks/3_Anciennes versions/3k_08-11 etat avant rangement final/1_ASSEMBLAGE_FINAL (a utiliser)/Vis M3x8.SLDPRT
01_SolidWorks/3_Anciennes versions/3l_13-11 avant renforts U, patins, pince/Pieces bras/Servo MG996R arm01.SLDPRT
01_SolidWorks/3_Anciennes versions/3a_premiere version sans contraintes/bras.SLDPRT
01_SolidWorks/3_Anciennes versions/3a_premiere version sans contraintes/bras.stl
01_SolidWorks/3_Anciennes versions/3a_premiere version sans contraintes/bride_coude.SLDPRT
01_SolidWorks/3_Anciennes versions/3a_premiere version sans contraintes/plateau.SLDPRT
01_SolidWorks/3_Anciennes versions/3a_premiere version sans contraintes/socle.SLDPRT
01_SolidWorks/3_Anciennes versions/3a_premiere version sans contraintes/socle.stl
01_SolidWorks/3_Anciennes versions/3b_28-10 sans servos/avant_bras.SLDPRT
01_SolidWorks/3_Anciennes versions/3b_28-10 sans servos/bras.SLDPRT
01_SolidWorks/3_Anciennes versions/3b_28-10 sans servos/bride_coude.SLDPRT
01_SolidWorks/3_Anciennes versions/3b_28-10 sans servos/corps_pince.SLDPRT
01_SolidWorks/3_Anciennes versions/3b_28-10 sans servos/machoire_a.SLDPRT
01_SolidWorks/3_Anciennes versions/3b_28-10 sans servos/machoire_b.SLDPRT
01_SolidWorks/3_Anciennes versions/3b_28-10 sans servos/pignon_pince.SLDPRT
01_SolidWorks/3_Anciennes versions/3b_28-10 sans servos/plateau.SLDPRT
01_SolidWorks/3_Anciennes versions/3b_28-10 sans servos/socle.SLDPRT
01_SolidWorks/3_Anciennes versions/3c_29-10 sans empreintes de palonniers/Palonnier MG996R.SLDPRT
01_SolidWorks/3_Anciennes versions/3c_29-10 sans empreintes de palonniers/Servo MG90S.SLDPRT
01_SolidWorks/3_Anciennes versions/3c_29-10 sans empreintes de palonniers/Servo MG996R.SLDPRT
01_SolidWorks/3_Anciennes versions/3c_29-10 sans empreintes de palonniers/avant_bras.SLDPRT
01_SolidWorks/3_Anciennes versions/3c_29-10 sans empreintes de palonniers/avant_bras.step
01_SolidWorks/3_Anciennes versions/3c_29-10 sans empreintes de palonniers/bras.SLDPRT
01_SolidWorks/3_Anciennes versions/3c_29-10 sans empreintes de palonniers/bras.step
01_SolidWorks/3_Anciennes versions/3c_29-10 sans empreintes de palonniers/bride_coude.SLDPRT
01_SolidWorks/3_Anciennes versions/3c_29-10 sans empreintes de palonniers/bride_coude.step
01_SolidWorks/3_Anciennes versions/3c_29-10 sans empreintes de palonniers/bride_poignet.SLDPRT
01_SolidWorks/3_Anciennes versions/3c_29-10 sans empreintes de palonniers/bride_poignet.step
01_SolidWorks/3_Anciennes versions/3c_29-10 sans empreintes de palonniers/corps_pince.SLDPRT
01_SolidWorks/3_Anciennes versions/3c_29-10 sans empreintes de palonniers/corps_pince.step
01_SolidWorks/3_Anciennes versions/3c_29-10 sans empreintes de palonniers/machoire_a.SLDPRT
01_SolidWorks/3_Anciennes versions/3c_29-10 sans empreintes de palonniers/machoire_a.step
01_SolidWorks/3_Anciennes versions/3c_29-10 sans empreintes de palonniers/machoire_b.SLDPRT
01_SolidWorks/3_Anciennes versions/3c_29-10 sans empreintes de palonniers/machoire_b.step
01_SolidWorks/3_Anciennes versions/3c_29-10 sans empreintes de palonniers/pignon_pince.SLDPRT
01_SolidWorks/3_Anciennes versions/3c_29-10 sans empreintes de palonniers/pignon_pince.step
01_SolidWorks/3_Anciennes versions/3c_29-10 sans empreintes de palonniers/plateau.SLDPRT
01_SolidWorks/3_Anciennes versions/3c_29-10 sans empreintes de palonniers/plateau.step
01_SolidWorks/3_Anciennes versions/3c_29-10 sans empreintes de palonniers/socle.SLDPRT
01_SolidWorks/3_Anciennes versions/3c_29-10 sans empreintes de palonniers/socle.step
01_SolidWorks/3_Anciennes versions/3d_30-10 contraintes en conflit/Servo MG90S.SLDPRT
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
