amauryvandenberghe/Bras-robos/05_Documentation/images/anciennes analyses/assemblage_q1.png

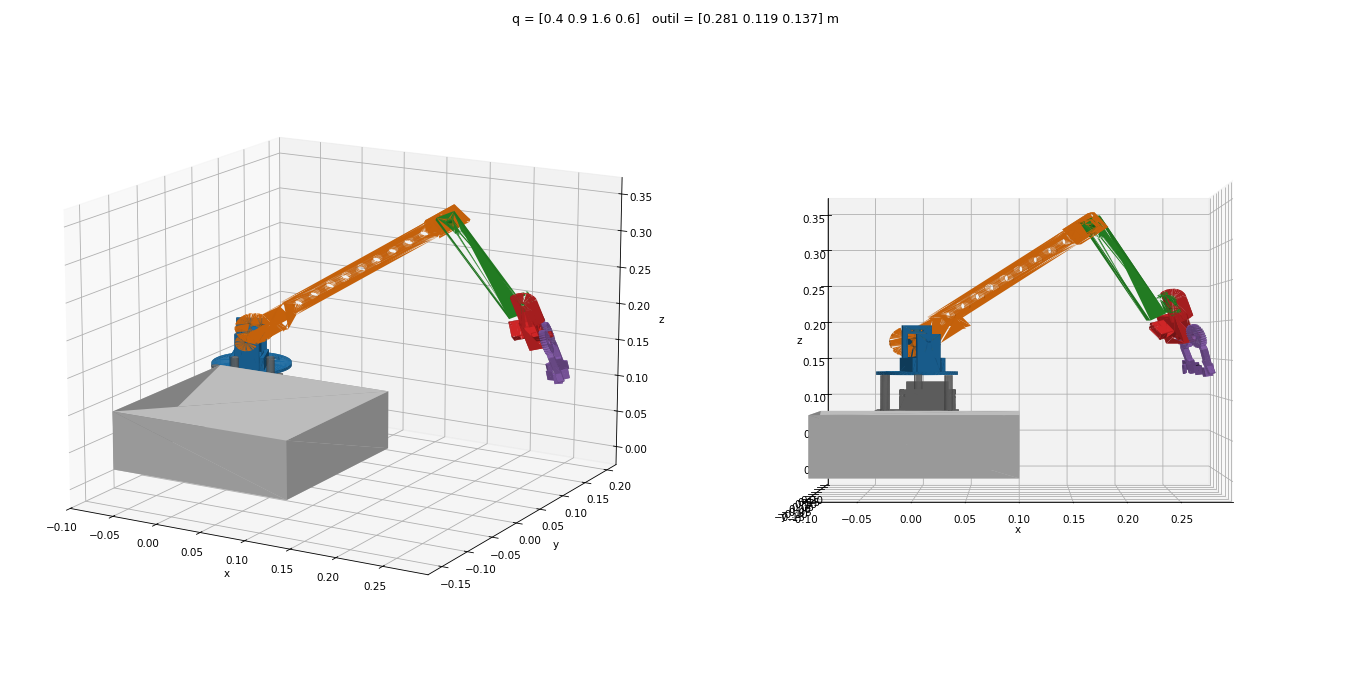
05_Documentation/images/anciennes analyses/assemblage_q1.png
