amauryvandenberghe/Bras-robos/(commit log)

2026-11-08 Import initial du projet bras robotisé
    Claude-Session: https://claude.ai/code/session_01QyExLKY2CK4zUV7e3yTAgN
    [Assemblage1.SLDASM, Assemblage1v2.SLDASM, Bras 50cm.SLDASM, Ecrou M3.SLDPRT, Ecrou M3.step, L298N Motor Driver.step.SLDPRT, MG996R SBORKA.SLDASM, Palonnier MG996R.SLDPRT]
2026-11-09 CLAUDE.md court + HISTORIQUE.md, hook post-commit (graphe local + push)
    CLAUDE.md passe de 65 Ko à un mémo court : le détail complet est
    déplacé tel quel dans HISTORIQUE.md (lu par mot-clé, à la demande).
    .githooks/post-commit : graphify update . si du code a changé, puis git push.
    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
2026-11-11 ESP32 : nouveau cablage du 11/11 (direction 17, bras 19/18/23/22/16, L298N 25/33/32), test des 6 servos sur 90 degres
2026-11-11 bras_robot : commande de direction O<n> de l'application, televerse avec le cablage du 11/11
2026-11-11 bras_robot : bouton 3 = test base et epaule avec tous les servos tenus
2026-11-11 bras_robot : suivi de ligne (commande N), capteurs 27/15/34 et 26/14/35
2026-11-12 Programme provisoire de calage des palonniers (calage_servos)
2026-11-12 Suivi de ligne : marche avant corrigee, direction adoucie ; test de l'epaule
    [bras_robot.ino]
2026-11-12 bras_robot : poignet inverse autour de son calage
2026-11-12 bras_robot : boutons 1, 2, 3 = sequence mimee, suivi de ligne sur les 3 capteurs avant
2026-11-12 Base, epaule, coude sur les broches 21, 4, 13
2026-11-12 Notes : abaisseur de tension, coude remplace, poignet immobile
2026-11-12 Programme robot_simple : conduite, suivi N, sequence du bras un servo a la fois, poignet coupe
2026-11-12 Diagnostic camera + USB (diag_bras), robot_simple en degres servo : bouton 1 = sequence du bras
2026-11-13 robot_simple : derniere version (sequence vue a la camera le 12/11), avant regroupement dans bras_robot
2026-11-13 Programme unique bras_robot (ino + servo.h/cpp + reseau.h) : Home bas, suivi de ligne doux, mission aleatoire par le reseau ; anciens croquis retires
2026-11-13 CAO 13/11 : U du bras renforce, patins et gorge de la base, pince a flasque et machoires neuves, STL
    [Assemblage1v2.SLDASM, Bras 50cm.SLDASM, Ecrou M3.SLDPRT, Ecrou M3.step, L298N Motor Driver.step.SLDPRT, Rondelle M3.SLDPRT, Rondelle M3.step, Roulement 608.SLDPRT]
2026-11-13 Notice de montage 13/11, notes Gazebo (URDF regenere, masses a jour)
2026-11-13 Validation Gazebo du 13/11 avec les nouvelles masses : 9 sequences sur 10
2026-11-13 bras_robot : commande USB D (essai d'un servo a un angle donne, active le poignet)
2026-11-13 Poignet : sens inverse et pince remontee alignee a 115 degres, verifie a la camera
